bhorst519/bluecar/EIM/pcb/EIM/EIM_BOM.xlsx

Item # | *Designator | *Qty | Manufacturer | *Mfg Part # | Description / Value | *Package/Footprint | Type | Your Instructions / Notes
1 | D15,D29,D28 | 3 | Littelfuse | SD05-01FTG | TVS Diode 5V 450W Unidirectional | D_SOD-323 | SMD
2 | D19,D25,D21,D14,D11,D24,D16,D13,D31,D17,D30,D20,D18,D22,D23 | 15 | Littelfuse | SD15-01FTG | TVS Diode 15V 450W Unidirectional | D_SOD-323 | SMD
3 | J1 | 1 | JAE | MX34028NF2 | Automotive 28P Connector | MX34028NF2 | DNS | DO NOT PLACE
4 | R53,R27,R47,R49,R31,R51,R37,R33,R43,R29,R45,R41,R39,R35 | 14 | YAGEO | RT0805FRE07470RL | RES 470 ohm 1/8W 1% 0805 SMD | R_0805 | SMD | EQUIVALENT PART OKAY
5 | R15,R18 | 2 | YAGEO | RC0805JR-1310KL | RES 10kohm 1/8W 5% 0805 SMD | R_0805 | DNS | DO NOT PLACE
6 | IC3,IC10,IC9,IC7,IC5,IC4,IC6,IC8 | 8 | Vishay | ILD213T | Optocouplers Phototransistor Dual Output | SOIC127P610X350-8N | SMD
7 | U8,U9,U7,U5,U6,U10,U11 | 7 | Infineon | BTS6142D | Smart High Side 1 Ch 39V 100A | TO-252-4 | SMD
8 | J5,J6 | 2 | Samtec | SSW-110-03-T-D | Socket Strip Header .100" Pitch 2X10 | PinHeader_2x10_P2.54mm | DNS | DO NOT PLACE
9 | R38,R25,R62,R24,R42,R46,R71,R50,R70,R34,R74,R30,R8,R26,R66,R17,R75,R91,R59,R58,R63,R67,R92,R55 | 24 | YAGEO | RC0805JR-1310KL | RES 10kohm 1/8W 5% 0805 SMD | R_0805 | SMD | EQUIVALENT PART OKAY
10 | C7,C16,C38,C41,C27,C26,C18,C32,C46,C37,C15,C45,C48,C47,C12,C19,C39,C14,C5,C8,C33,C13,C2,C17,C43,C9,C10,C36,C31,C40,C6,C42,C11,C35,C44,C1,C25,C30,C21 | 39 | KYOCERA AVX | 08055C104J4Z4A | CAP 100nF 50V X7R 0805 SMD | C_0805 | SMD | EQUIVALENT PART OKAY
11 | R4,R23,R61,R73,R64,R89,R68,R56,R72,R65,R87,R90,R57,R2,R69,R88,R16,R22,R60 | 19 | YAGEO | RC0805JR-131KL | RES 1kohm 1/4W 5% 0805 SMD | R_0805 | SMD | EQUIVALENT PART OKAY
12 | Q5,Q2,Q1,Q6,Q4,Q3,Q7 | 7 | omsemi | BSS138 | MOSFET N-CH LOGIC 50V 220mA | SOT-23 | SMD
13 | D2 | 1 | Lumex | SML-LXF0805SIC-TR | Standard LED Red 0805 SMD | LED_0805 | SMD | EQUIVALENT PART OKAY
14 | SW1,SW2 | 2 | C&K | PTS645SM43SMTR92 LFS | Tactile Switches 6 mm SMD | SW_SPST_PTS645 | SMD
15 | D10 | 1 | Vishay | VS-1EFH01-M3/I | Rectifiers Hypfst 1A 100V DO-219AB-2 SMD | D_SMF (DO-219AB-2) | SMD
16 | K1 | 1 | Omron | G8N-1L-AS DC12 | Automotive Mini Relay 12V 30A | G8N1LASDC12 | DNP
17 | S3,S2,S1 | 3 | Infineon | BTS3800SLHTSA1 | Automotive Lowside Relay Driver | BTS3800SLHTSA1 | SMD
18 | FB2 | 1 | TDK | MPZ2012S221AT000 | Ferrite Bead 220ohms 3A 25% 0805 SMD | L_0805 | SMD | EQUIVALENT PART OKAY
19 | D5 | 1 | Lumex | SML-LXT0805YW-TR | Standard LED Yellow 0805 SMD | LED_0805 | SMD | EQUIVALENT PART OKAY
20 | R10,R19,R14,R13 | 4 | YAGEO | AC0805FR-07120RL | RES 120ohm 1/8W 1% 0805 SMD | R_0805 | SMD | EQUIVALENT PART OKAY
21 | R78,R83,R80,R86,R76 | 5 | Panasonic | ERJ-UP6D3601V | RES 3.6kohm 1/8W 0.5% 0805 SMD | R_0805 | SMD | EQUIVALENT PART OKAY
22 | C29,C28 | 2 | Panasonic | EEE-FN1C220R | CAP Electrolytic 22uF 16VDC 20% 90mA AEC-Q200 | CP_Elec_4x5.8 | SMD
23 | R12,R32,R44,R40,R52,R11,R9,R28,R36,R48 | 10 | Vishay | CRCW08050000Z0ECC | RES 0ohm 1/8W 0805 SMD | R_0805 | SMD | EQUIVALENT PART OKAY
24 | C24,C20,C23 | 3 | Samsung | CL31B106KBHNNNE | CAP MLCC 10uF 50V X7R 10% 1206 SMD | C_1206 | SMD
25 | F1 | 1 | Littelfuse | 1206L035/16YR | Polyfuse PTC 16V 0.350A 1206 SMD | Fuse_1206 | SMD
26 | F2 | 1 | Littelfuse | 2920L600/16MR | Polyfuse PTC 16V 6.0A 2920 SMD | Fuse_2920 | SMD
27 | R20,R21 | 2 | Vishay | CRCW080510R0FKEA | RES thick film 10ohm 1/8W 1% 0805 SMD | R_0805 | SMD | EQUIVALENT PART OKAY
28 | F5 | 1 | Littelfuse | 1206L010/60WR | Polyfuse PTC 60V 0.100A 1206 SMD | Fuse_1206 | SMD
29 | R84,R79,R81,R77 | 4 | Panasonic | ERJ-P06D1001V | RES 1kohm 1/8W 0.5% 0805 SMD | R_0805 | SMD | EQUIVALENT PART OKAY
30 | U1 | 1 | STMicroelectronics | STM32F429ZIT6 | ARM MCU CortexM4 2Mb Flash 180MHz | LQFP-144_20x20mm_P0.5mm | SMD
31 | J7 | 1 | Samtec | FTSH-107-01-F-DV-K | 14-pin Header Strip, .050" pitch | FTSH-107-XX-YYY-DV-K | SMD
32 | R82 | 1 | Bourns | CR2512-JW-221ELF | RES thick film 220ohm 1W 5% 2512 SMD | R_2512 | SMD | EQUIVALENT PART OKAY
33 | R6,R54,R5,R85 | 4 | Panasonic | ERA-6AED221V | RES 220ohm 1/8W 0.5% 0805 SMD | R_0805 | SMD | EQUIVALENT PART OKAY
34 | X1 | 1 | ABRACON | ASE-8.000MHz-E-T | Standard Clock Oscillator 8.000MHZ CMOS SMD | Oscillator_ASE-4Pin_3.2x2.5mm | SMD
35 | D4 | 1 | Lumex | SML-LX0805DRC-TR | Standard LED Deep Red 0805 SMD | LED_0805 | SMD | EQUIVALENT PART OKAY
36 | D6 | 1 | Diotec | SK22 | Schottky Diode, 20V, 2A, SMB SMD | D_SMB | SMD
37 | FB1 | 1 | Wurth Elektronik | 742792040 | Ferrite Bead 600ohms 2A 25% 0805 SMD | L_0805 | SMD | EQUIVALENT PART OKAY
38 | IC2 | 1 | Renesas | ISL3172EIBZ | RS-485 Interface IC SOIC-8 SMD | SOIC-8_3.9x4.9mm_P1.27mm | SMD
39 | U4,U3 | 2 | Texas Instruments | SN65HVD233 | CAN Interface IC Standby Mode SOIC-8 SMD | SOIC-8_3.9x4.9mm_P1.27mm | SMD
40 | D26,D27 | 2 | Littelfuse | SD12-01FTG | TVS Diode 12V 450W Unidirectional | D_SOD-323 | SMD
41 | D12,D8,D9 | 3 | Littelfuse | SM24CANB-02HTG | TVS Diode 500W 24V 2 CH SOT23 SMD | SOT-23-3 | SMD
42 | R3,R1 | 2 | YAGEO | RT0603FRE0715KL | RES 15kohm 1/8W 1% 0805 SMD | R_0805 | SMD | EQUIVALENT PART OKAY
43 | C4,C3 | 2 | YAGEO | CC1206KKX7R7BB225 | CAP MLCC 2.2uF 16V X7R 10% 1206 SMD | C_1206 | SMD
44 | J8 | 1 | Samtec | TSW-106-07-T-S | Male Header Strip 0.1" Pitch 1X6 | PinHeader_1x06_P2.54mm_Vertical | DNS | DO NOT PLACE
45 | X2 | 1 | ECS | ECS-327MVATX-3-CN-TR3 | Standard Clock Oscillators 32.768KHZ SMD | Oscillator_ASE-4Pin_3.2x2.5mm | SMD
46 | L1 | 1 | Bourns | SRN8040-3R6Y | Power Inductors 3.6uH 30% 8040 SMD | L_Bourns-SRN8040_8x8.15mm | SMD
47 | IC1 | 1 | Texas Instruments | TLIN1027DRQ1 | Automotive LIN Transceiver SOIC-8 SMD | SOIC-8_3.9x4.9mm_P1.27mm | SMD
48 | J4 | 1 | Molex | 34830-2001 | Automotive Connector MX150 RA 2X10 BLK KEY A | 348302001 | DNS | DO NOT PLACE
49 | C22 | 1 | Wurth Elektronik | 885012207078 | CAP MLCC 1.0uF 25V X7R 10% 0805 SMD | C_0805 | SMD
50 | R7 | 1 | YAGEO | AC0805FR-7W1K5L | RES 1.5kohm 1/4W 1% 0805 SMD | R_0805 | SMD | EQUIVALENT PART OKAY
51 | F3,F4 | 2 | Littelfuse | 2920L260/33DR | Polyfuse PTC 33V 2.6A 2920 SMD | Fuse_2920 | SMD
52 | J3 | 1 | Molex | 34830-0801 | Automotive Connector MX150 RA 2X4 BLK KEY A | 348300801 | DNS | DO NOT PLACE
53 | C34 | 1 | KEMET | C0805C221J5GAC | CAP 220pF 50V C0G 0805 5% SMD | C_0805 | SMD | EQUIVALENT PART OKAY
54 | D7 | 1 | Bourns | SMBJ15A | TVS Diode 15volts 5uA 24 Amps Unidirectional | D_SMB | SMD
55 | D3 | 1 | Lumex | SML-LXT0805GW-TR | Standard LED Green 0805 SMD | LED_0805 | SMD | EQUIVALENT PART OKAY
56 | U2 | 1 | Diodes Incorporated | AP63203WU-7 | Switching Voltage Regulators DCDC 3.3V Output | TSOT-23-6 | SMD
57 | J2 | 1 | Molex | 36783-1201 | Automotive Connectors MX120G RA 2X6 | 367831201 | DNS | DO NOT PLACE
58 | D1 | 1 | Cree LED | CLV1L-FKB-CJ1N1E1BB7B3B3 | Multi-Color LEDs RGB SMD | LED_Cree-PLCC4_3.2x2.8mm_CCW | SMD
