bhorst519/bluecar/(threads)

Thread 29 (2025-04-30):

Properly relay APS and switch info from VCU -> EIM

aguynamedsterl, 2025-04-30:
My hacky approach today ([PR](https://github.com/bhorst519/bluecar/pull/28)) is using the VCU_PcbaVitals message, which was intended to be debug-only and TXed at 10Hz. To accommodate use in powertrain control,  I increased the TX rate to 100Hz and have EIM consuming the message. We should create a proper, dedicated interface for these control signals
