bhorst519/bluecar/EIM/pcb/EIM/EIM.pdf

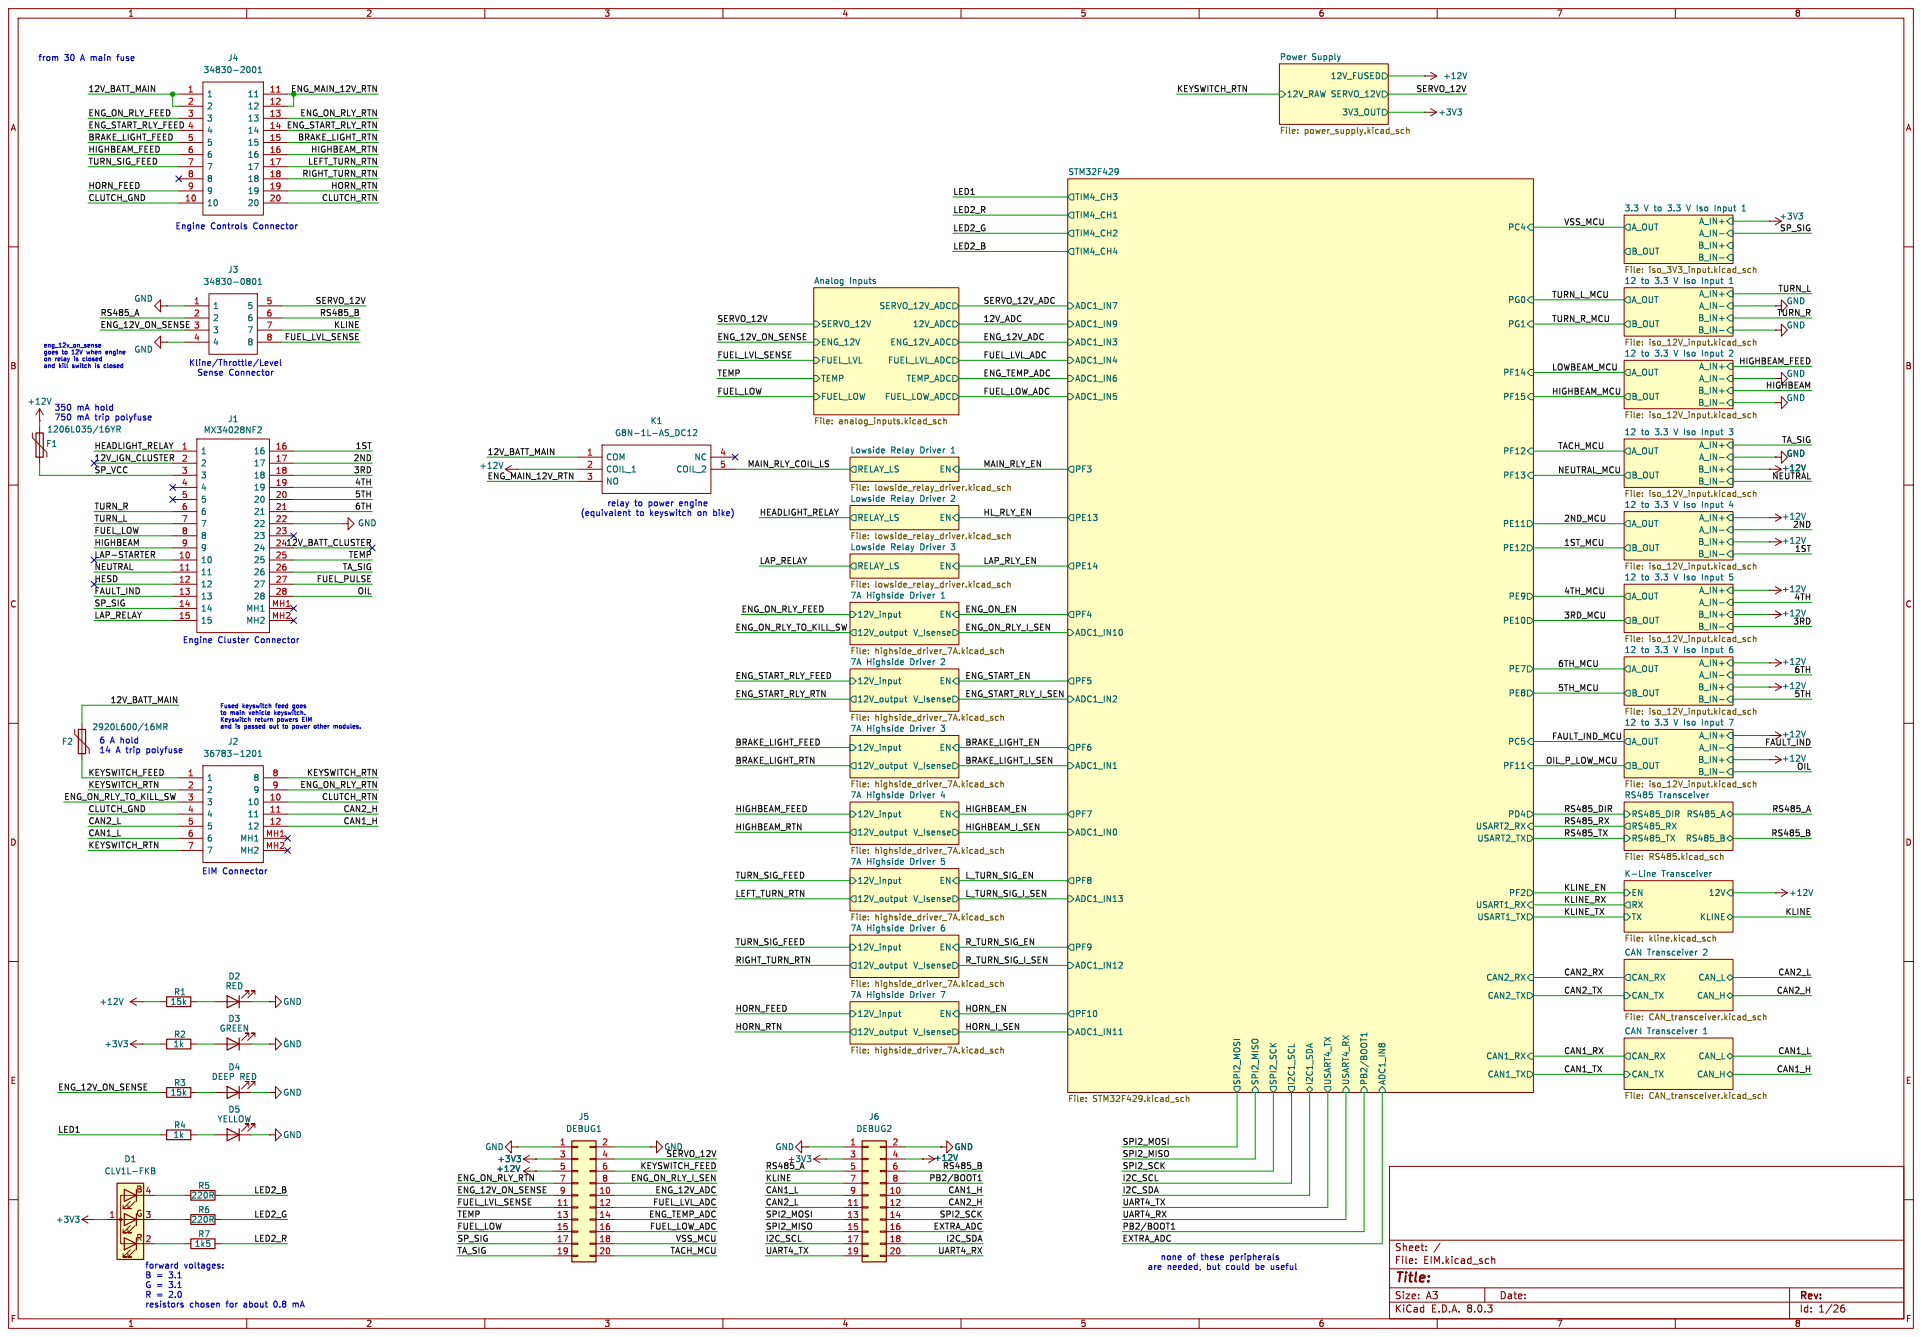
[picture p1: page 1]

3.3 V to 3.3 V Iso Input 1 File: iso_3V3_input.kicad_sch A_IN+ A_IN- B_IN+ B_IN- B_OUT A_OUT
A_IN+ A_IN- B_IN+ B_IN- B_OUT A_OUT

12 to 3.3 V Iso Input 3 File: iso_12V_input.kicad_sch A_IN+ A_IN- B_IN+ B_IN- B_OUT A_OUT

eng_12v_on_sense
goes to 12V when engine
on relay is closed
and kill switch is closed 350 mA hold

12 to 3.3 V Iso Input 2 File: iso_12V_input.kicad_sch

relay to power engine

12 to 3.3 V Iso Input 4 File: iso_12V_input.kicad_sch A_IN+ A_IN- B_IN+ B_IN- B_OUT A_OUT

12 to 3.3 V Iso Input 5 File: iso_12V_input.kicad_sch

and is passed out to power other modules. Engine Cluster Connector EIM Connector

12 to 3.3 V Iso Input 7 File: iso_12V_input.kicad_sch

UART4_RX
PB2/BOOT1
EXTRA_ADC
none of these peripherals are needed, but could be useful

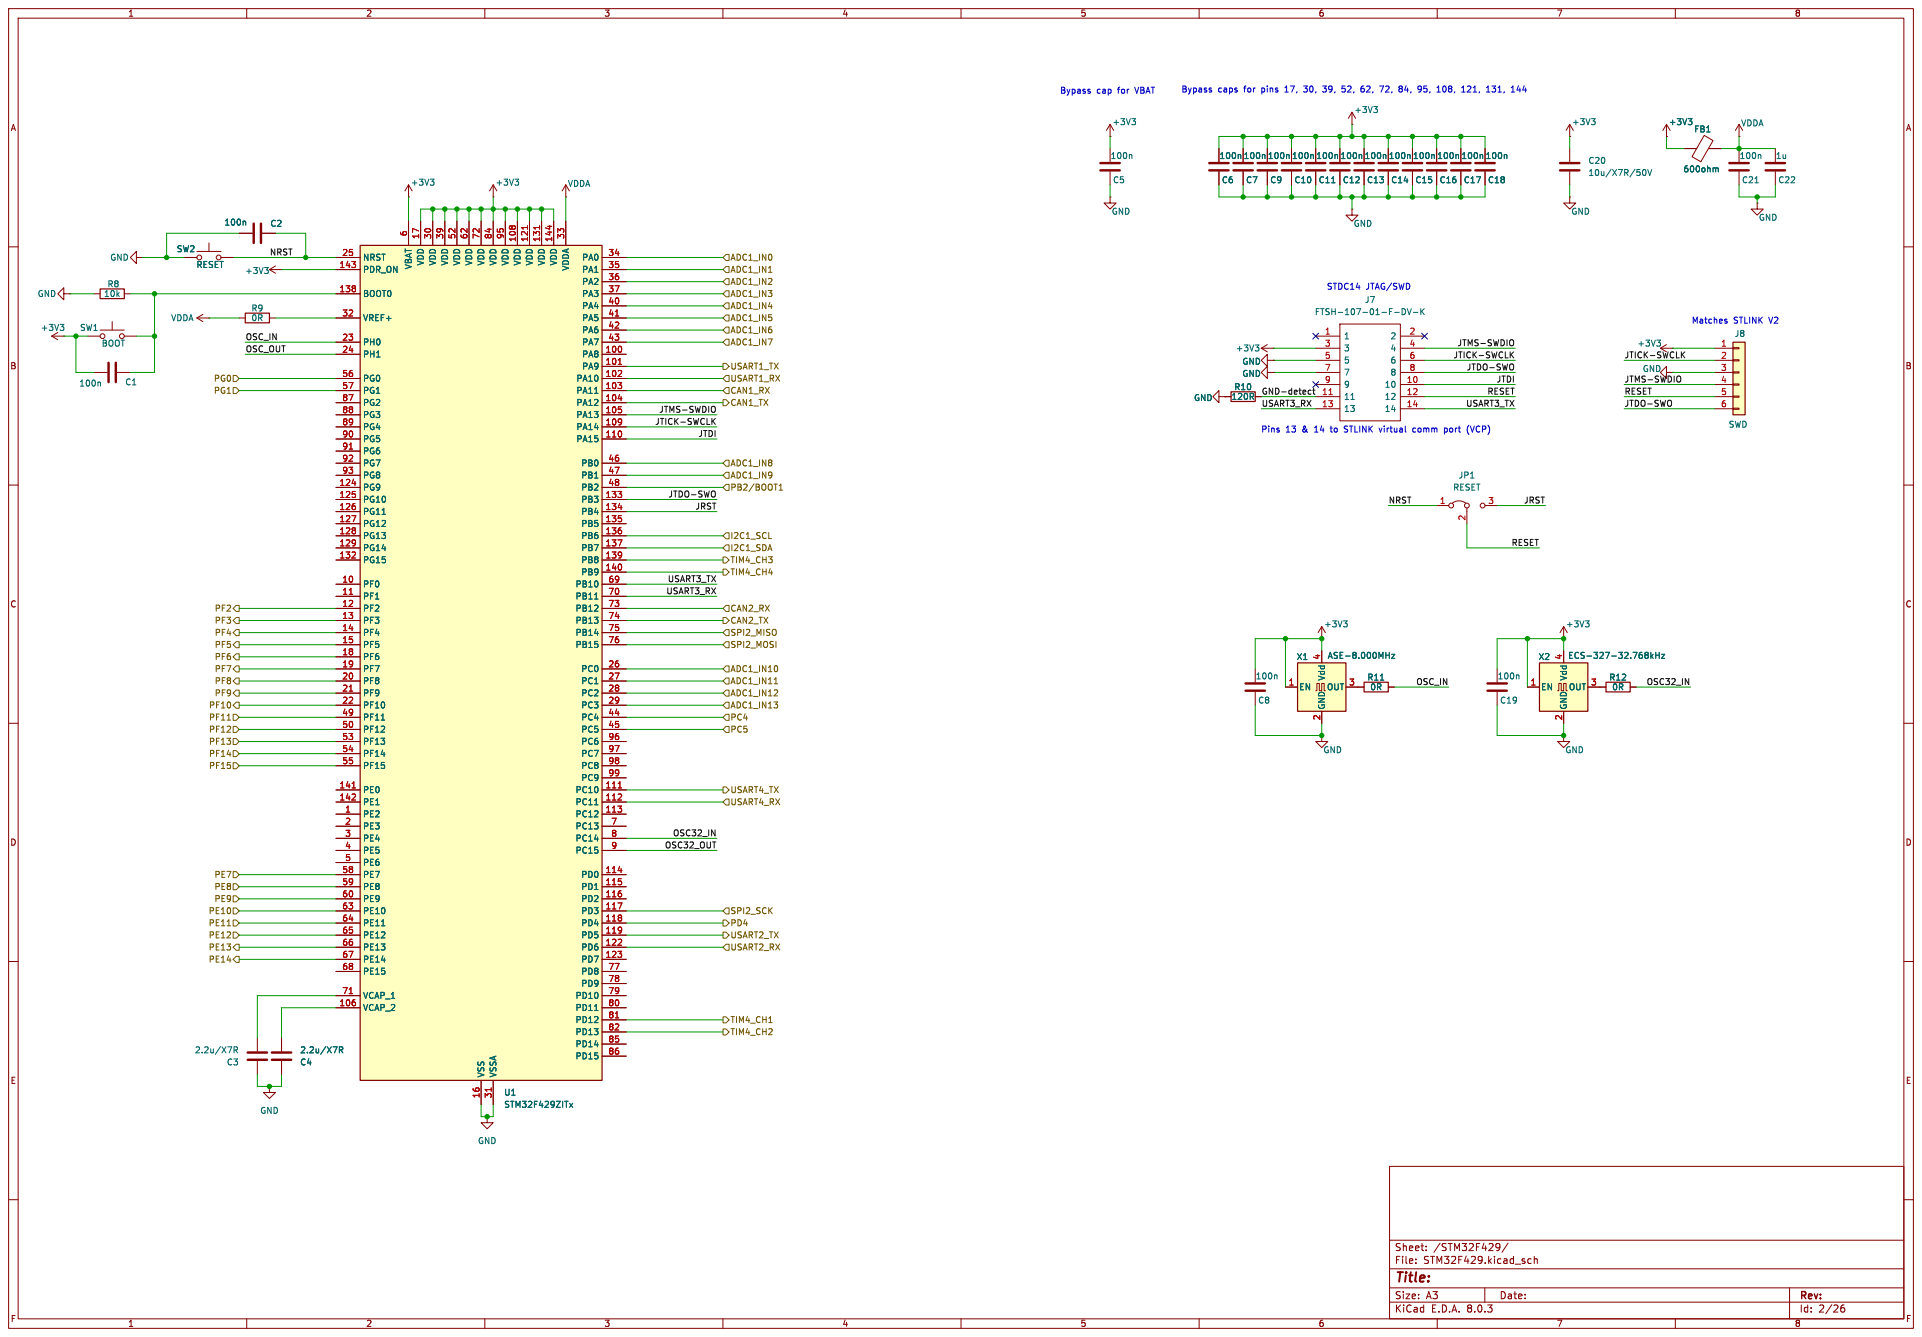
[picture p2: page 2]

J7 FTSH-107-01-F-DV-K GND GND

JTDI JRST RESET RESET NRST

Id: 2/26 Title: File: STM32F429.kicad_sch Sheet: /STM32F429/

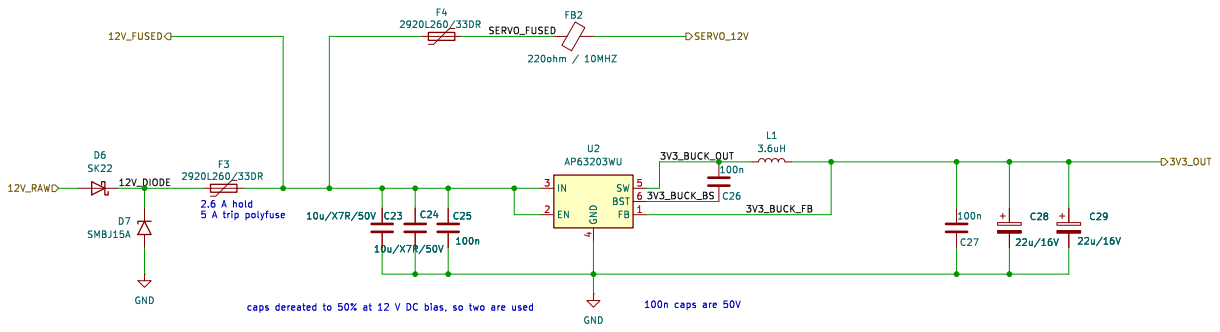
[picture p3: page 3]

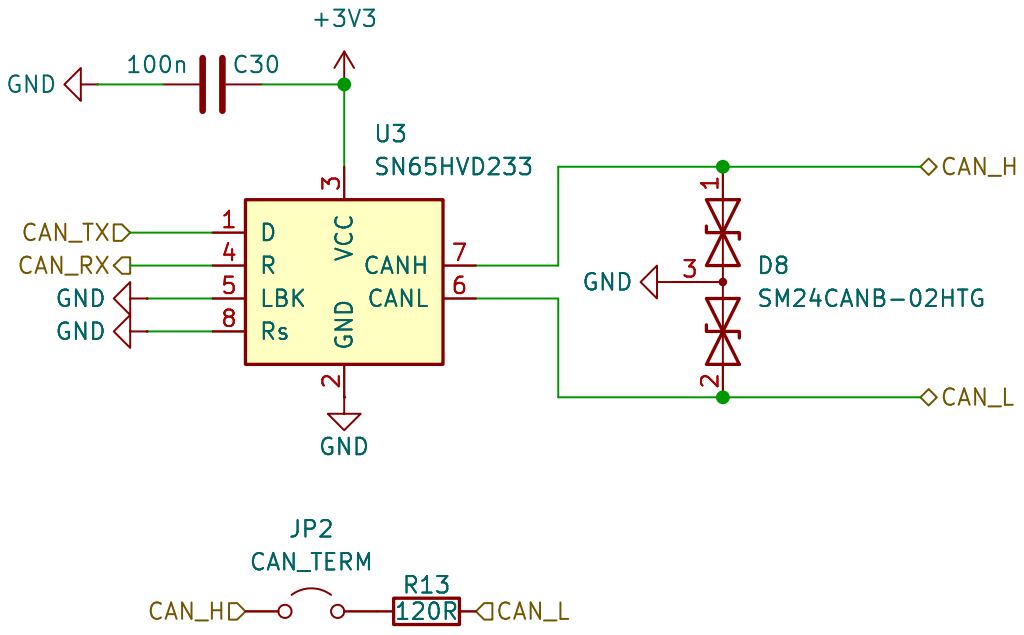
[picture p4: page 4]

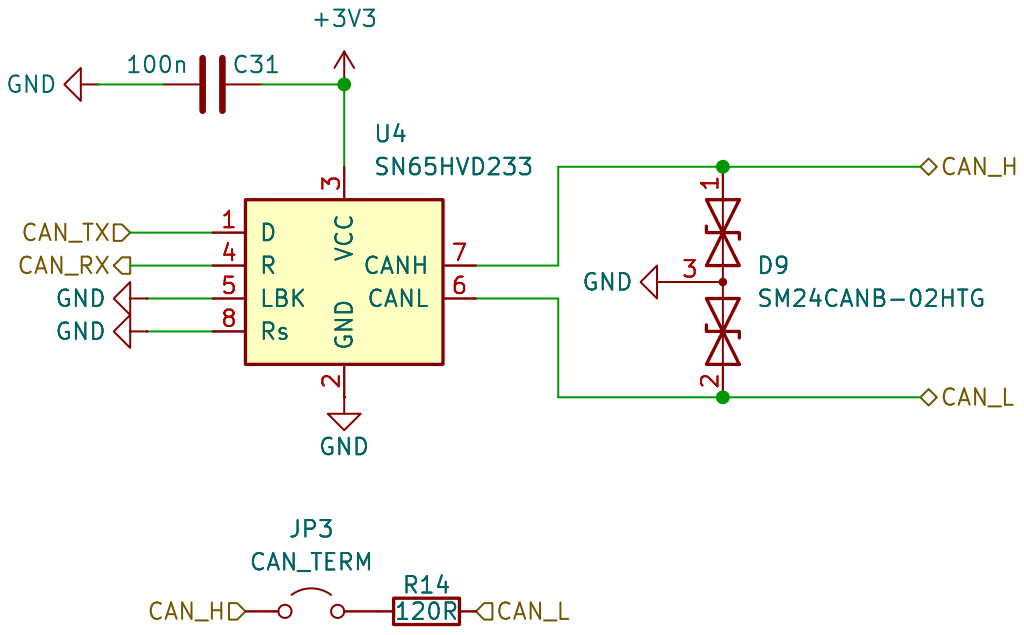
[picture p5: page 5]

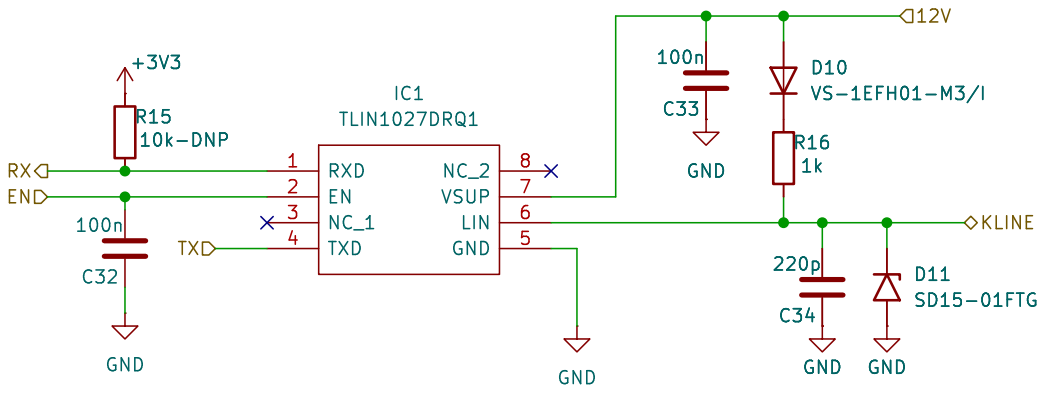
[picture p6: page 6]

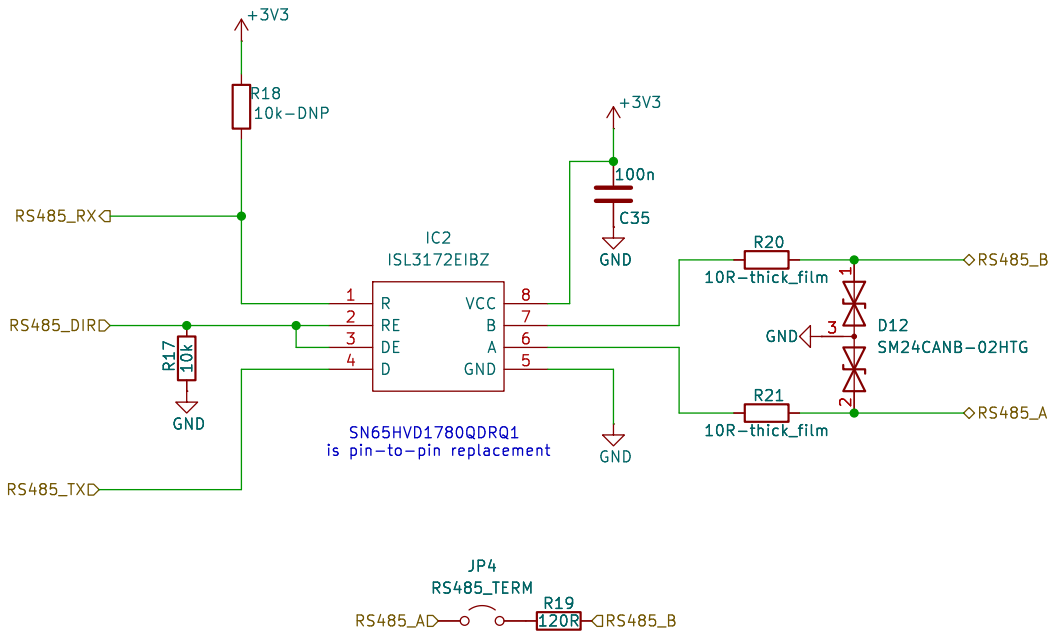
[picture p7: page 7]

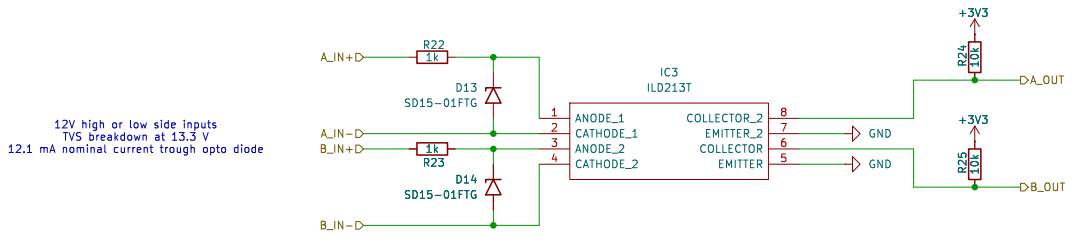
[picture p8: page 8]

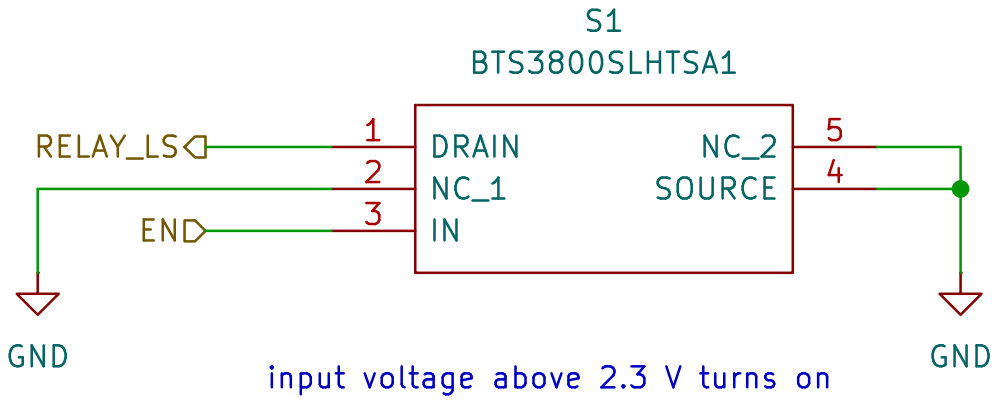
[picture p9: page 9]

input voltage above 2.3 V turns on

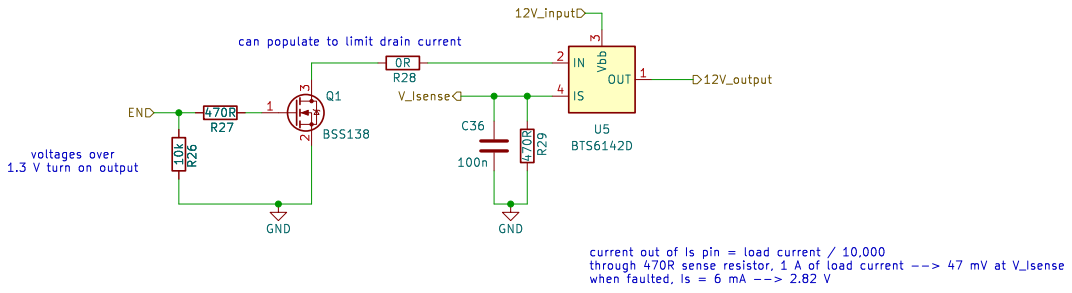
[picture p10: page 10]

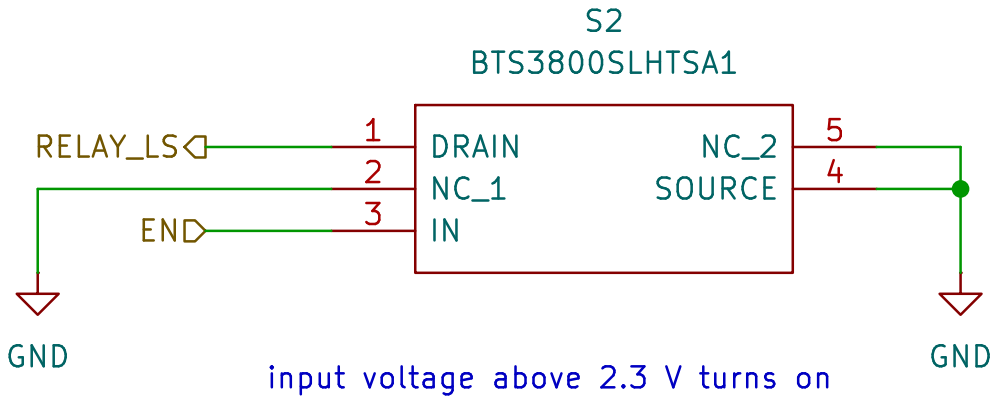
[picture p11: page 11]

input voltage above 2.3 V turns on

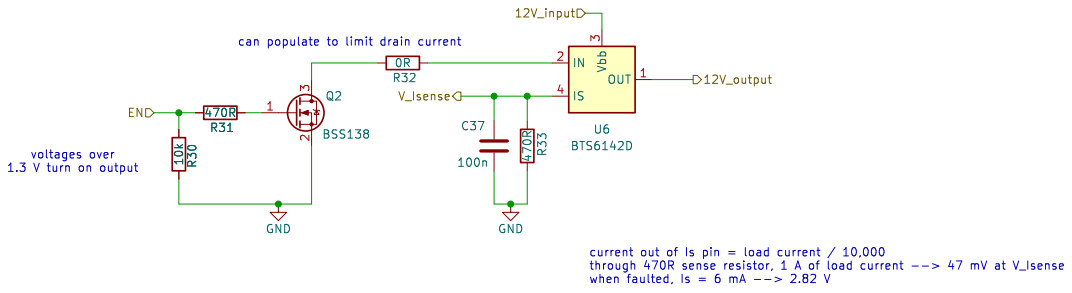
[picture p12: page 12]

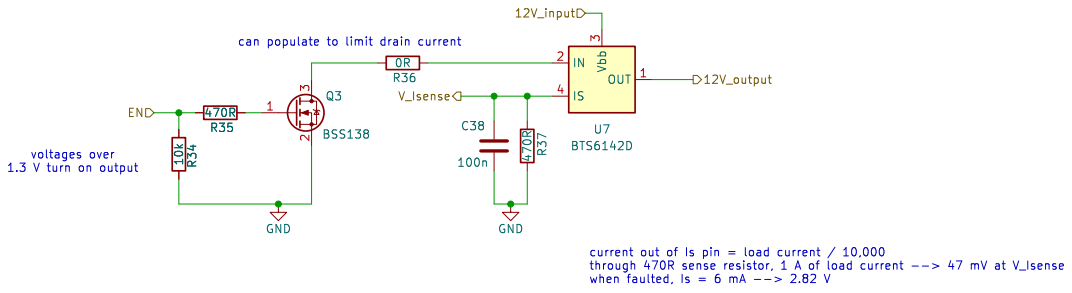
[picture p13: page 13]

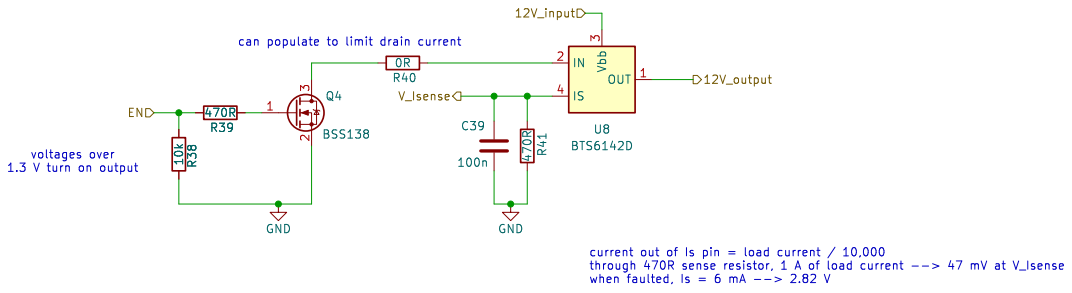
[picture p14: page 14]

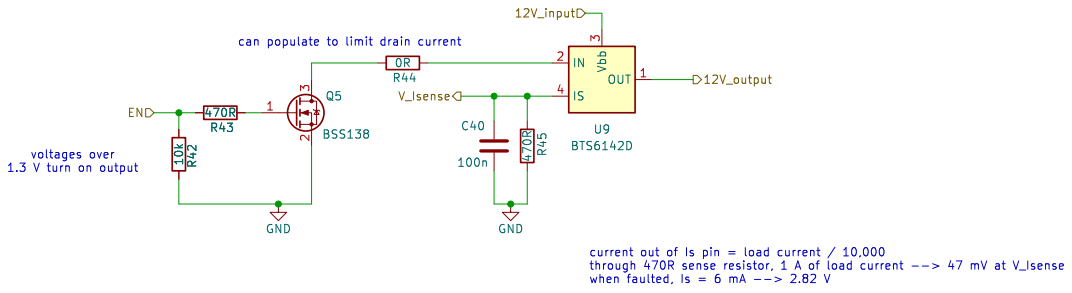
[picture p15: page 15]

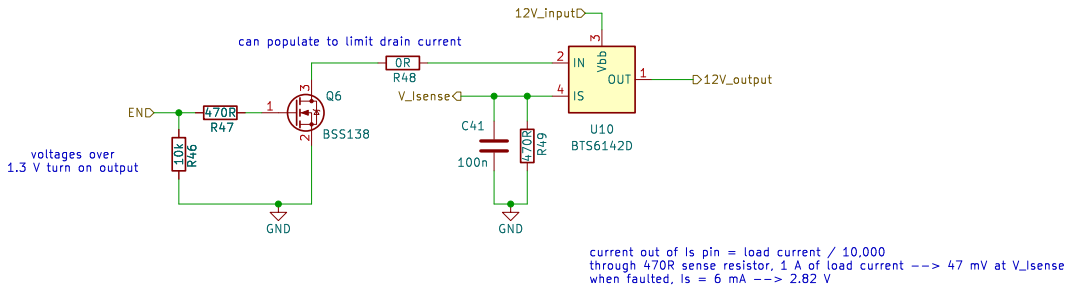
[picture p16: page 16]

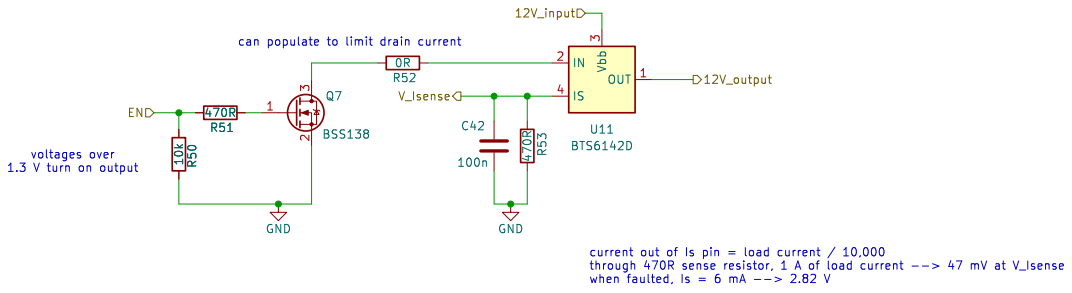
[picture p17: page 17]

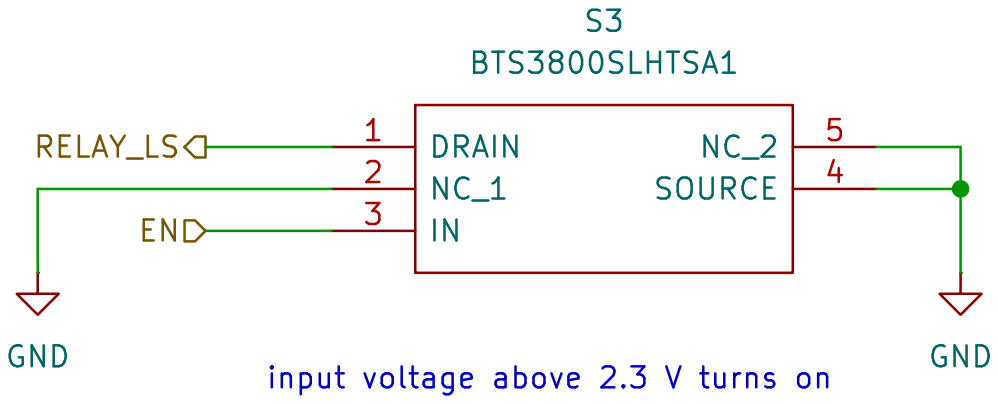
[picture p18: page 18]

input voltage above 2.3 V turns on

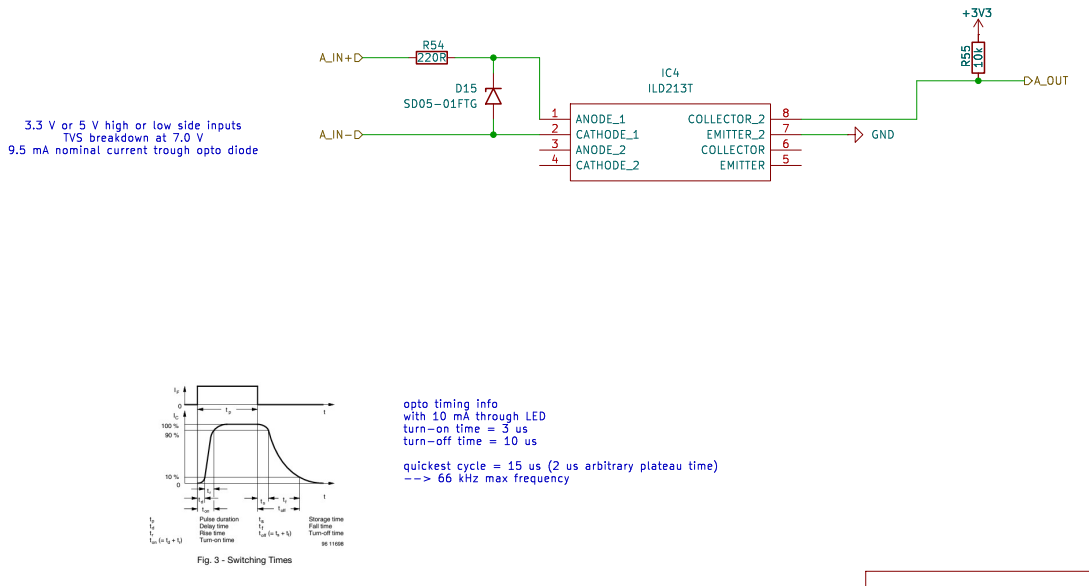
[picture p19: page 19]

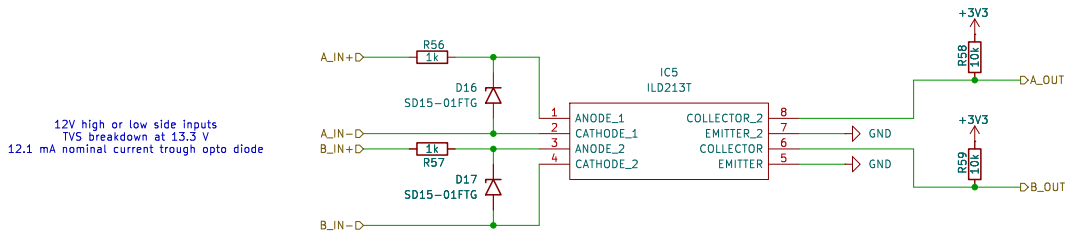
[picture p20: page 20]

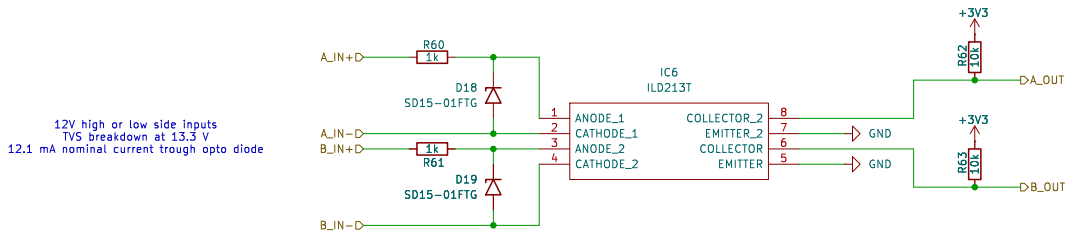
[picture p21: page 21]

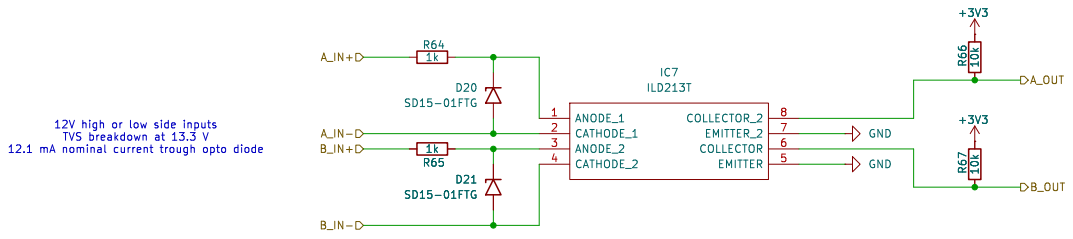
[picture p22: page 22]

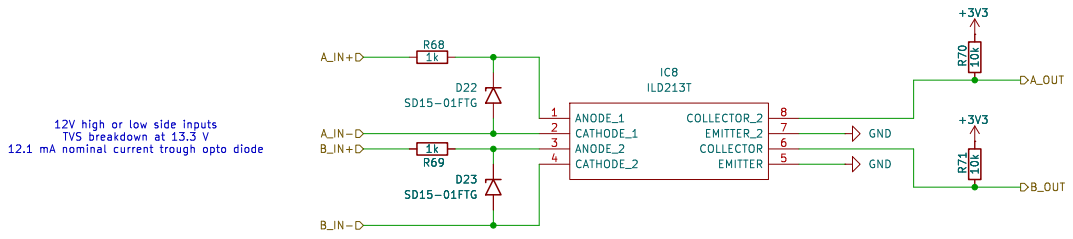
[picture p23: page 23]

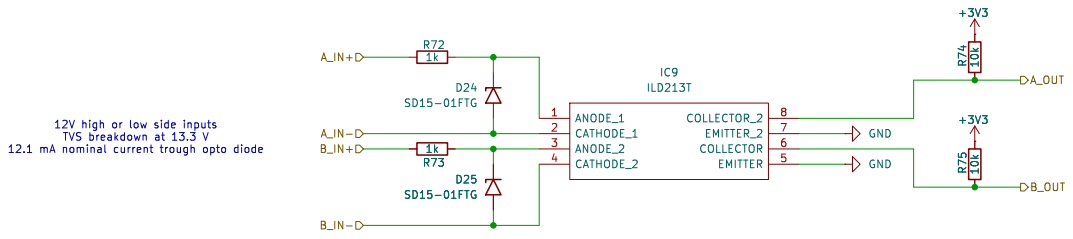
[picture p24: page 24]

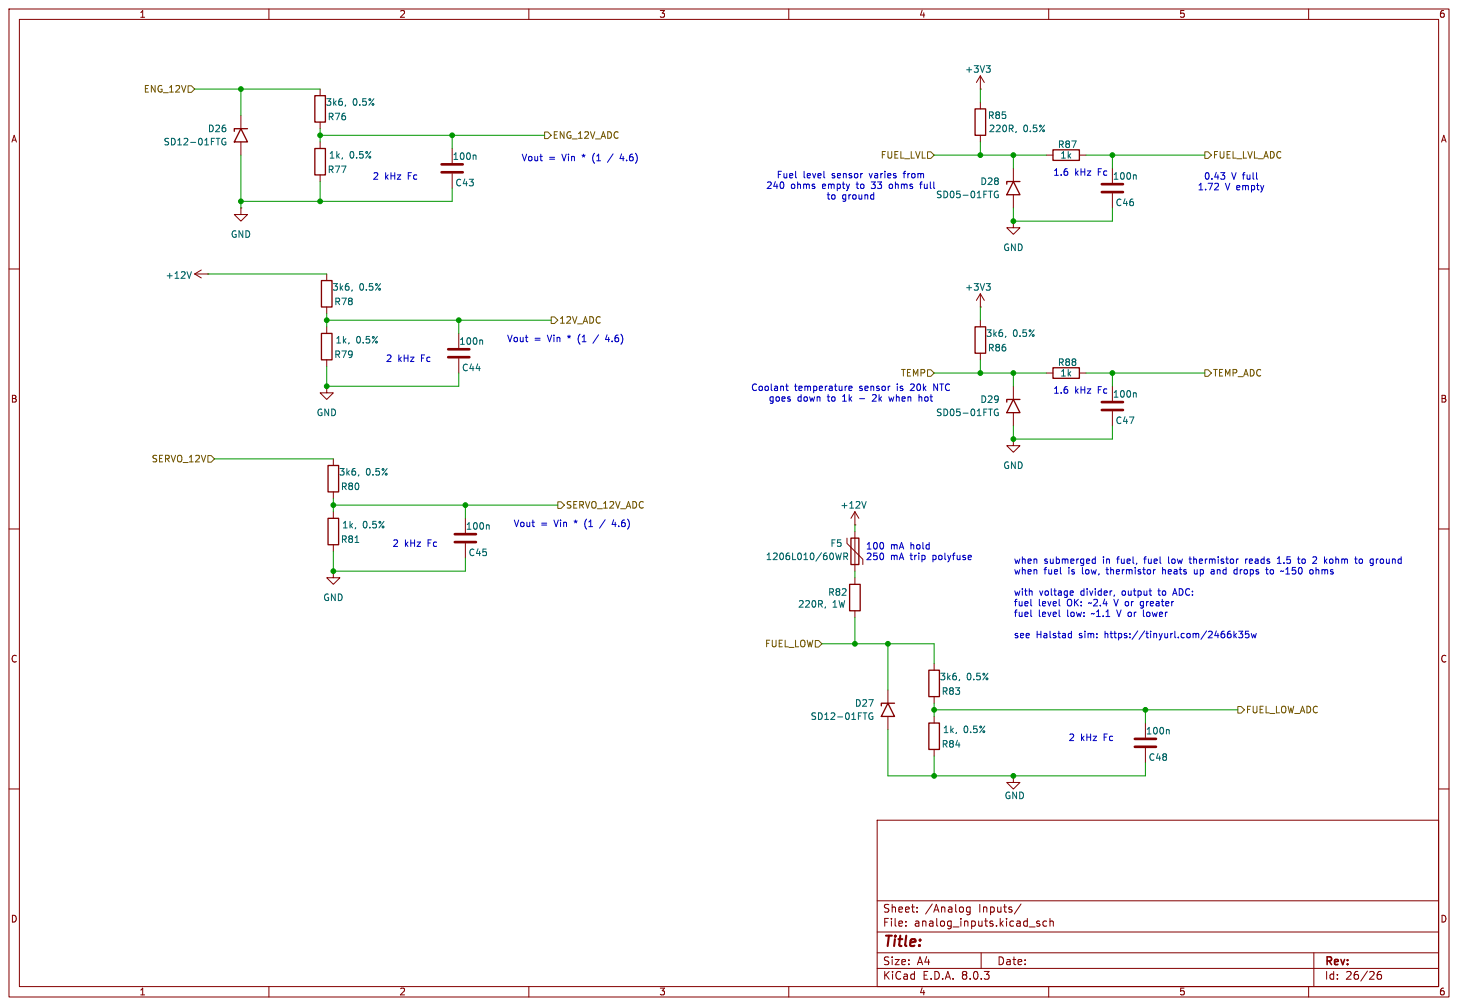
[picture p25: page 25]

240 ohms empty to 33 ohms full to ground

fuel level OK: ~2.4 V or greater
fuel level low: ~1.1 V or lower see Halstad sim: https://tinyurl.com/2466k35w

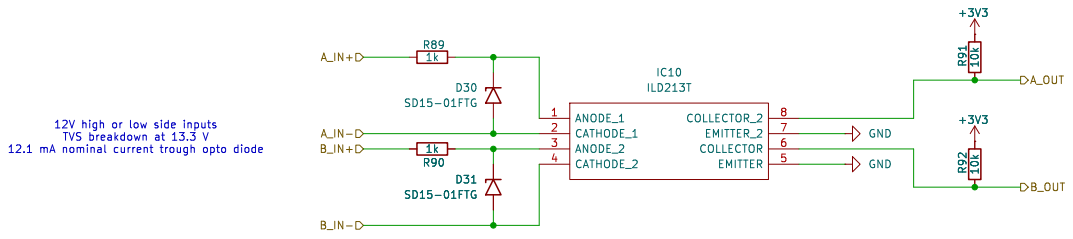
[picture p26: page 26]
