bhorst519/bluecar/VCU/temp_pcb/temp_vcu/temp_vcu.pdf

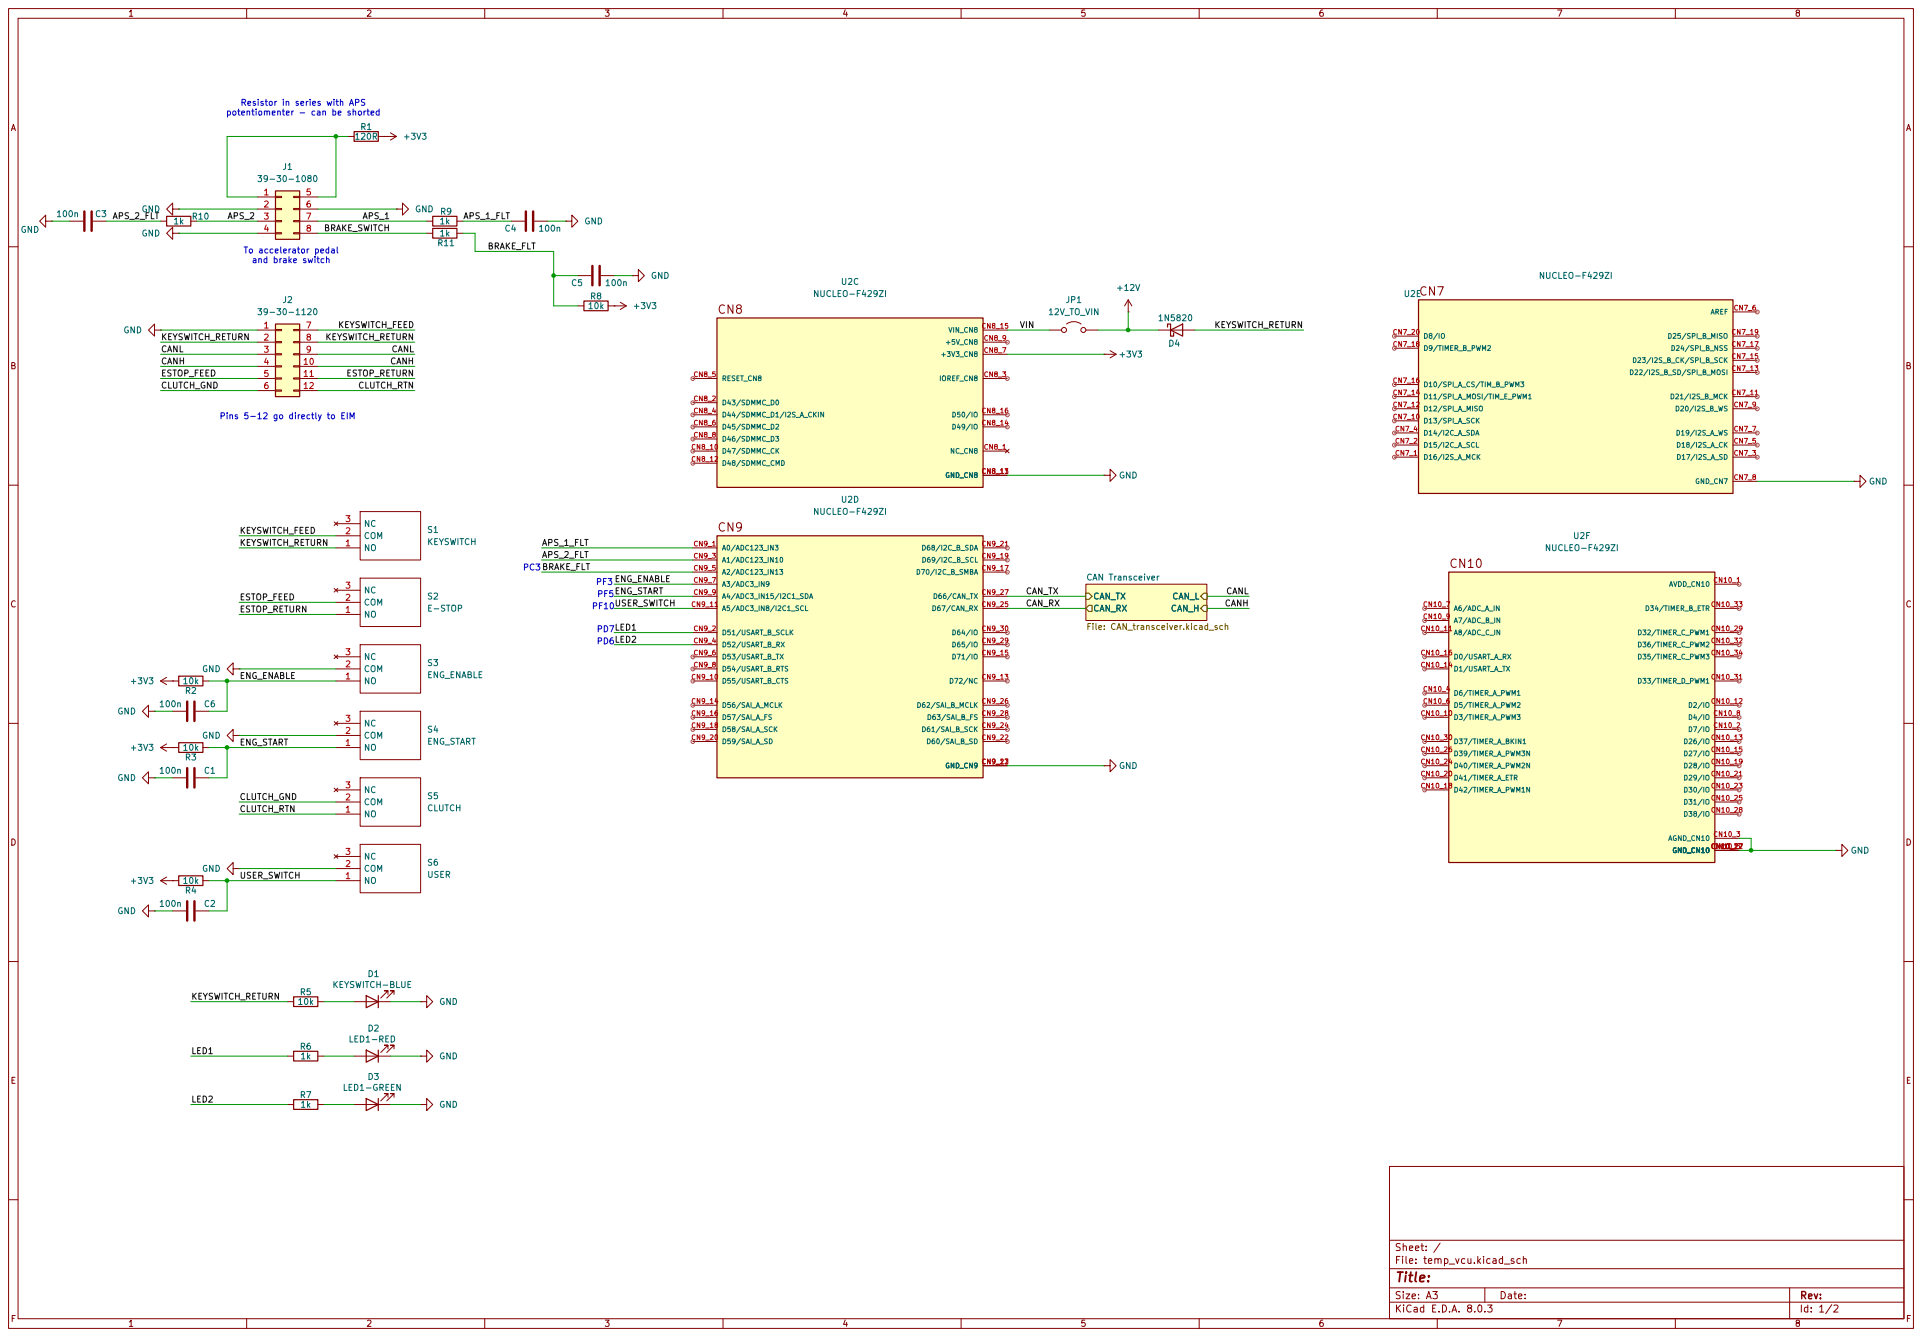
[picture p27: page 1]

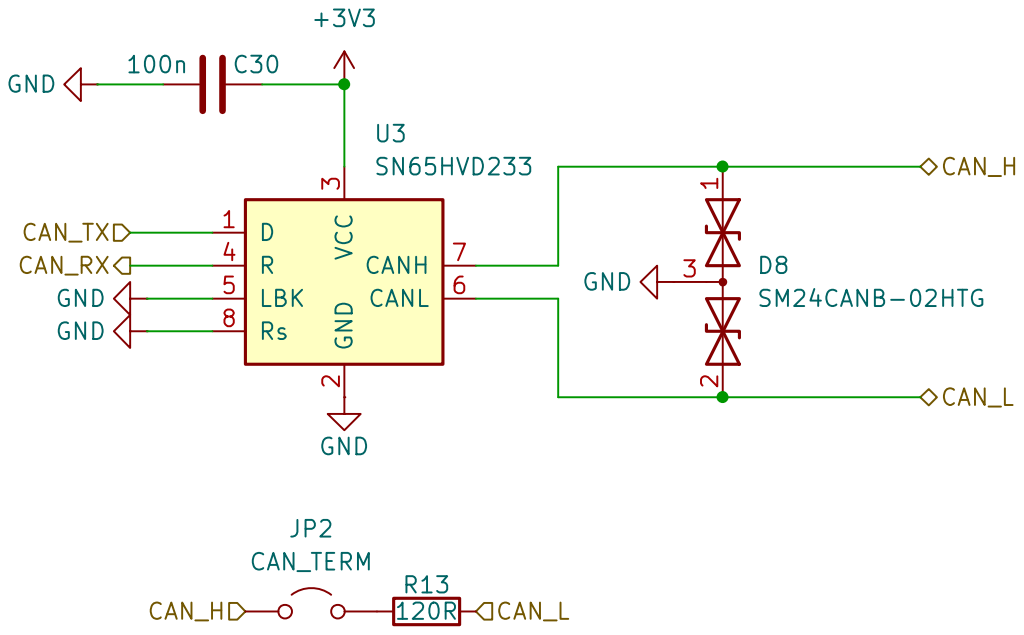
[picture p28: page 2]
