bhorst519/bluecar/VCU/temp_pcb/temp_vcu/temp_vcu.kicad_pcb

## KiCad design VCU/temp_pcb/temp_vcu/temp_vcu.kicad_pcb (2025-04-25)

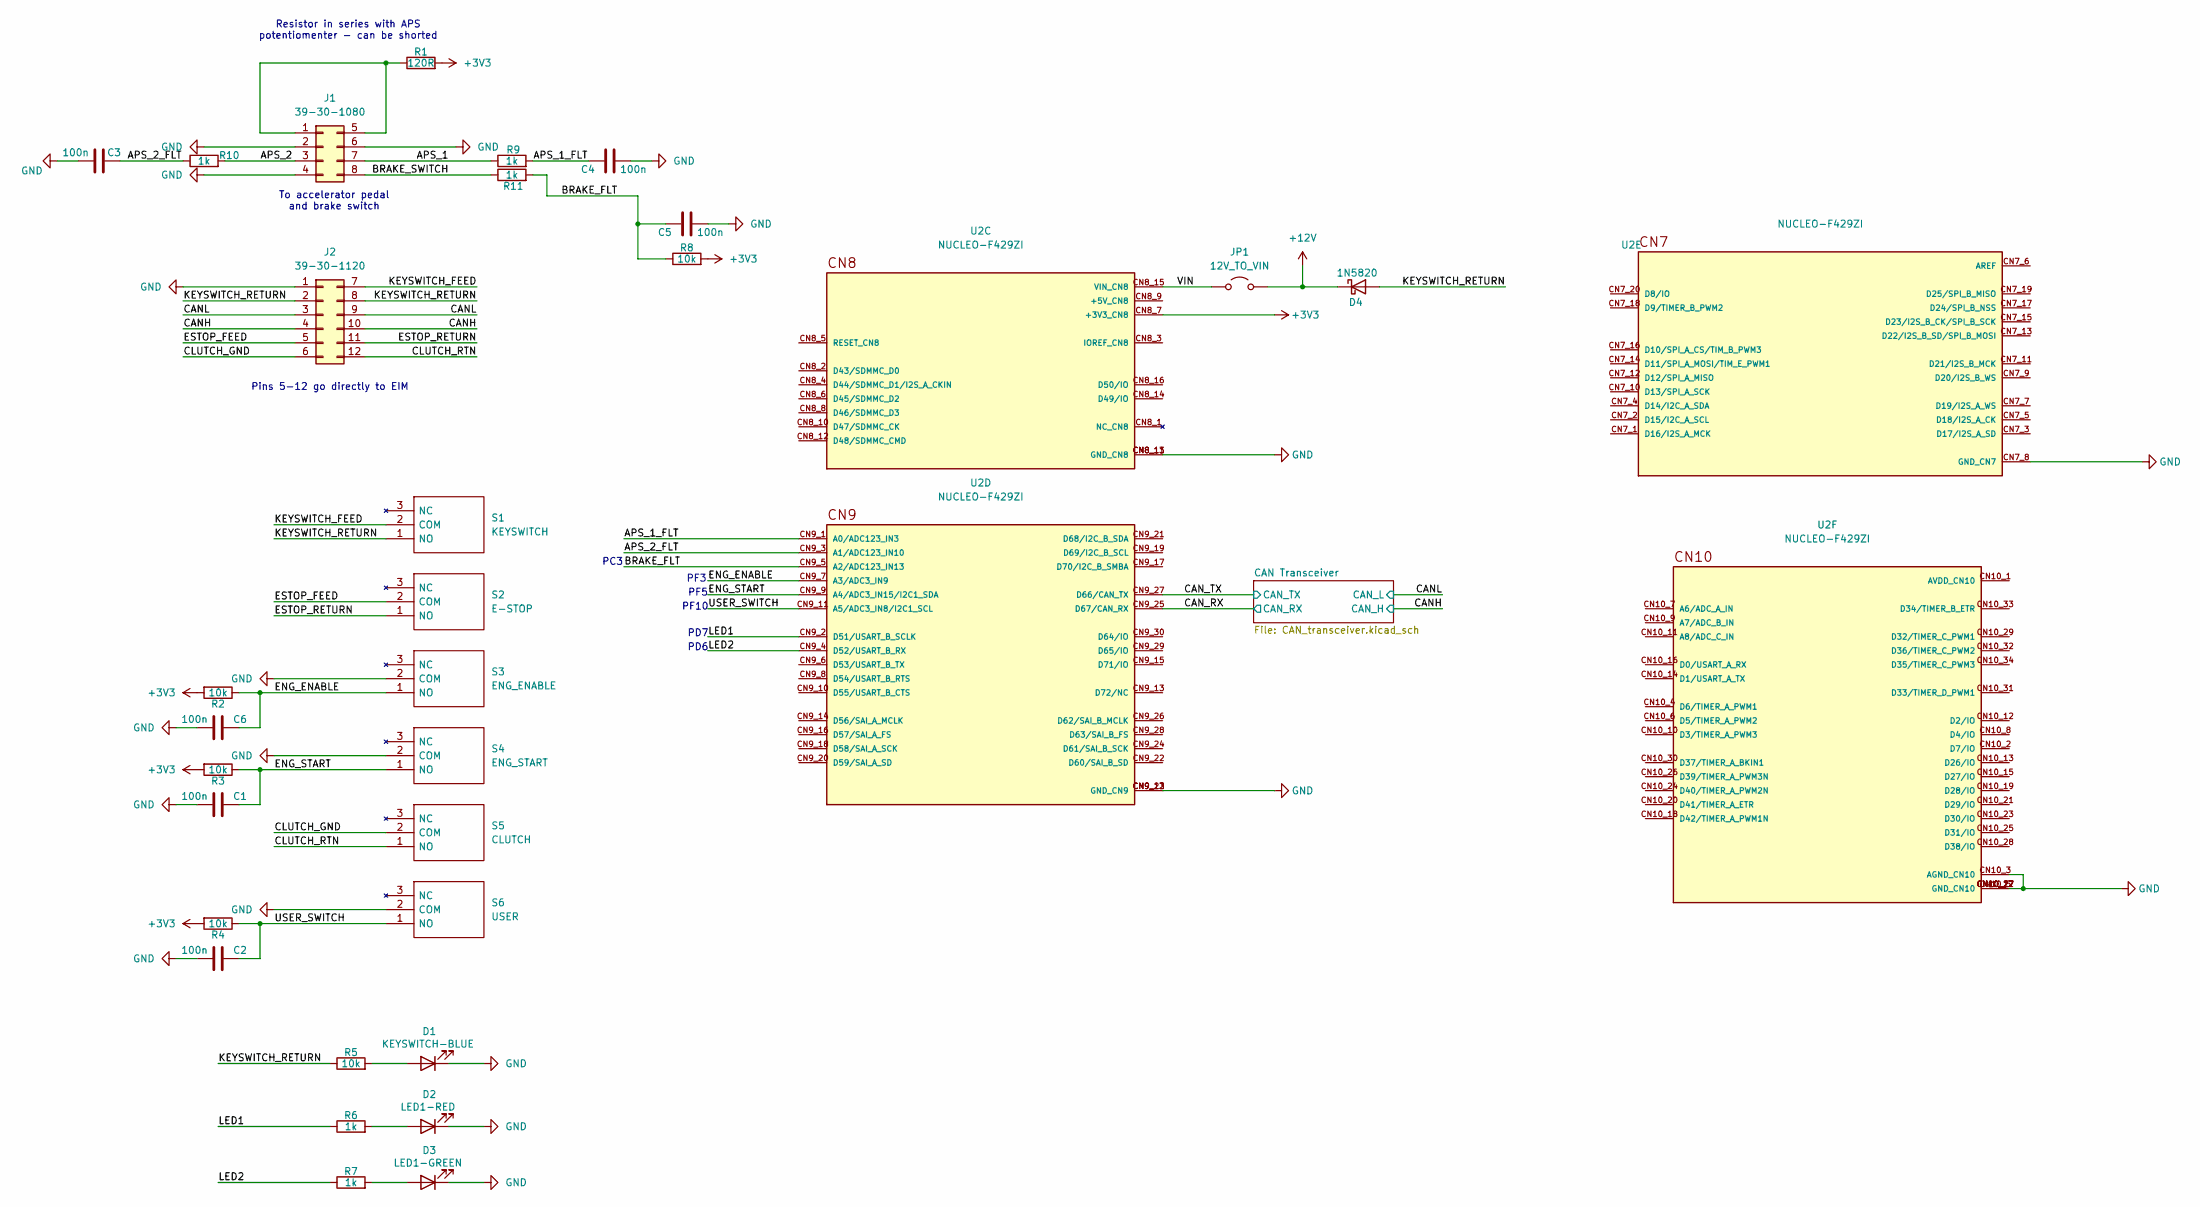
[picture p29: schematic temp_vcu.kicad_sch]

Parts:
C1, C2, C3, C4, C5, C6: 100n; C_0805_2012Metric_Pad1.18x1.45mm_HandSolder
D1: KEYSWITCH-BLUE; LED_D4.0mm
D2: LED1-RED; LED_D4.0mm
D3: LED1-GREEN; LED_D4.0mm
D4: 1N5820; D_DO-201AD_P15.24mm_Horizontal
J1: 39-30-1080; Molex_Mini-Fit_Jr_5569-08A2_2x04_P4.20mm_Horizontal
J2: 39-30-1120; Molex_Mini-Fit_Jr_5569-12A2_2x06_P4.20mm_Horizontal
JP1: 12V_TO_VIN; PinHeader_1x02_P2.54mm_Vertical
R1: 120R; R_Axial_DIN0207_L6.3mm_D2.5mm_P10.16mm_Horizontal
R2, R3, R4, R5, R8: 10k; R_Axial_DIN0207_L6.3mm_D2.5mm_P10.16mm_Horizontal
R6, R7, R9, R10, R11: 1k; R_Axial_DIN0207_L6.3mm_D2.5mm_P10.16mm_Horizontal
S1: KEYSWITCH; 2MS1T2B4M2QES; Mouser Part Number 118-2MS1T2B4M2QES
S2: E-STOP; 2MS1T2B4M2QES; Mouser Part Number 118-2MS1T2B4M2QES
S3: ENG_ENABLE; 2MS1T2B4M2QES; Mouser Part Number 118-2MS1T2B4M2QES
S4: ENG_START; 2MS1T2B4M2QES; Mouser Part Number 118-2MS1T2B4M2QES
S5: CLUTCH; 2MS1T2B4M2QES; Mouser Part Number 118-2MS1T2B4M2QES
S6: USER; 2MS1T2B4M2QES; Mouser Part Number 118-2MS1T2B4M2QES
U2: NUCLEO-F429ZI; MODULE_NUCLEO-F429ZI; PARTREV 8

Connections:
+3V3: R1.2, R2.2, R3.2, R4.2, R8.2, U2.CN8_7 (+3V3_CN8); also elsewhere on the board
+12V: D4.1 (K), JP1.2 (B)
/APS_1: J1.7, R9.1
/APS_1_FLT: C4.2, R9.2, U2.CN9_1 (A0/ADC123_IN3)
/APS_2: J1.3, R10.2
/APS_2_FLT: C3.2, R10.1, U2.CN9_3 (A1/ADC123_IN10)
/BRAKE_FLT: C5.2, R8.1, R11.2, U2.CN9_5 (A2/ADC123_IN13)
/BRAKE_SWITCH: J1.8, R11.1
/CANH: J2.4, J2.10; also elsewhere on the board
/CANL: J2.3, J2.9; also elsewhere on the board
/CAN_RX: U2.CN9_25 (D67/CAN_RX); also elsewhere on the board
/CAN_TX: U2.CN9_27 (D66/CAN_TX); also elsewhere on the board
/CLUTCH_GND: J2.6, S5.2 (COM)
/CLUTCH_RTN: J2.12, S5.1 (NO)
/ENG_ENABLE: C6.2, R2.1, S3.1 (NO), U2.CN9_7 (A3/ADC3_IN9)
/ENG_START: C1.2, R3.1, S4.1 (NO), U2.CN9_9 (A4/ADC3_IN15/I2C1_SDA)
/ESTOP_FEED: J2.5, S2.2 (COM)
/ESTOP_RETURN: J2.11, S2.1 (NO)
/KEYSWITCH_FEED: J2.7, S1.2 (COM)
/KEYSWITCH_RETURN: D4.2 (A), J2.2, J2.8, R5.1, S1.1 (NO)
/LED1: R6.1, U2.CN9_2 (D51/USART_B_SCLK)
/LED2: R7.1, U2.CN9_4 (D52/USART_B_RX)
/USER_SWITCH: C2.2, R4.1, S6.1 (NO), U2.CN9_11 (A5/ADC3_IN8/I2C1_SCL)
/VIN: JP1.1 (A), U2.CN8_15 (VIN_CN8)
GND: C1.1, C2.1, C3.1, C4.1, C5.1, C6.1, D1.1 (K), D2.1 (K), D3.1 (K), J1.2, J1.4, J1.6, J2.1, S3.2 (COM), S4.2 (COM), S6.2 (COM), U2.CN7_8 (GND_CN7), U2.CN8_11 (GND_CN8), U2.CN8_13 (GND_CN8), U2.CN9_12 (GND_CN9), U2.CN9_23 (GND_CN9), U2.CN10_3 (AGND_CN10), U2.CN10_5 (GND_CN10), U2.CN10_17 (GND_CN10), U2.CN10_22 (GND_CN10), U2.CN10_27 (GND_CN10); also elsewhere on the board
unnamed: D1.2 (A), R5.2
unnamed: D2.2 (A), R6.2
unnamed: D3.2 (A), R7.2
unnamed: J1.1, J1.5, R1.1

Notes on the sheet:
Resistor in series with APS potentiomenter - can be shorted
PF5
To accelerator pedal and brake switch
PD7
PD6
PF3
PF10
Pins 5-12 go directly to EIM
PC3

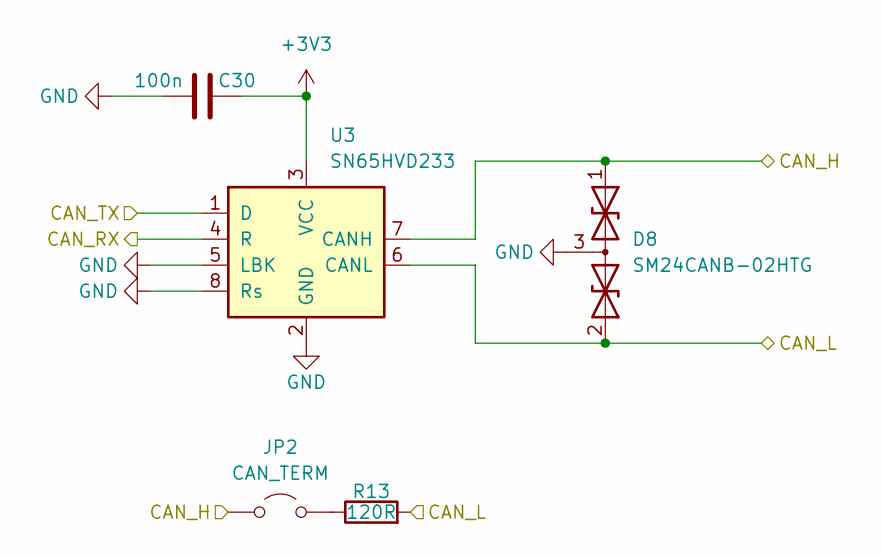
[picture p30: schematic CAN_transceiver.kicad_sch]

Parts:
C30: 100n; C_0805_2012Metric_Pad1.18x1.45mm_HandSolder
D8: SM24CANB-02HTG; SOT-23-3
JP2: CAN_TERM; PinHeader_1x02_P2.54mm_Vertical
R13: 120R; R_Axial_DIN0207_L6.3mm_D2.5mm_P10.16mm_Horizontal
U3: SN65HVD233; SOIC-8_3.9x4.9mm_P1.27mm

Connections:
+3V3: C30.2, U3.3 (VCC); also elsewhere on the board
/CANH: D8.1 (A1), JP2.1 (A), U3.7 (CANH); also elsewhere on the board
/CANL: D8.2 (A2), R13.2, U3.6 (CANL); also elsewhere on the board
/CAN_RX: U3.4 (R); also elsewhere on the board
/CAN_TX: U3.1 (D); also elsewhere on the board
GND: C30.1, D8.3 (common), U3.2 (GND), U3.5 (LBK), U3.8 (Rs); also elsewhere on the board
unnamed: JP2.2 (B), R13.1

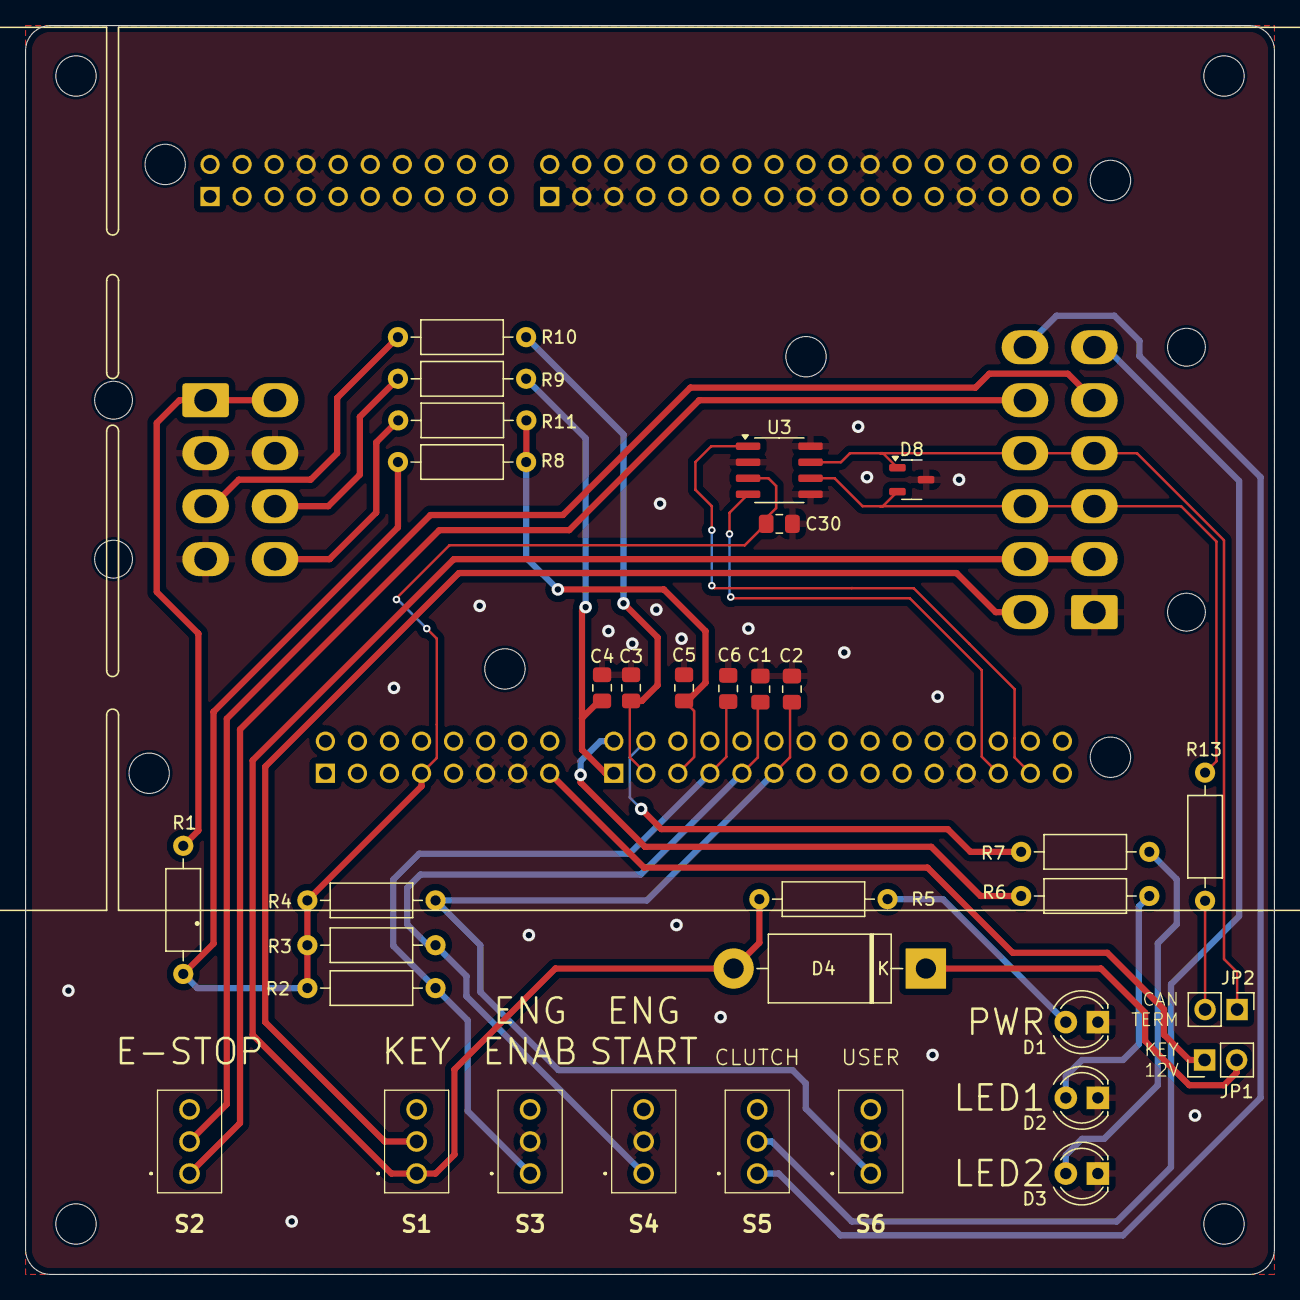
[picture p31: board temp_vcu.kicad_pcb from above]

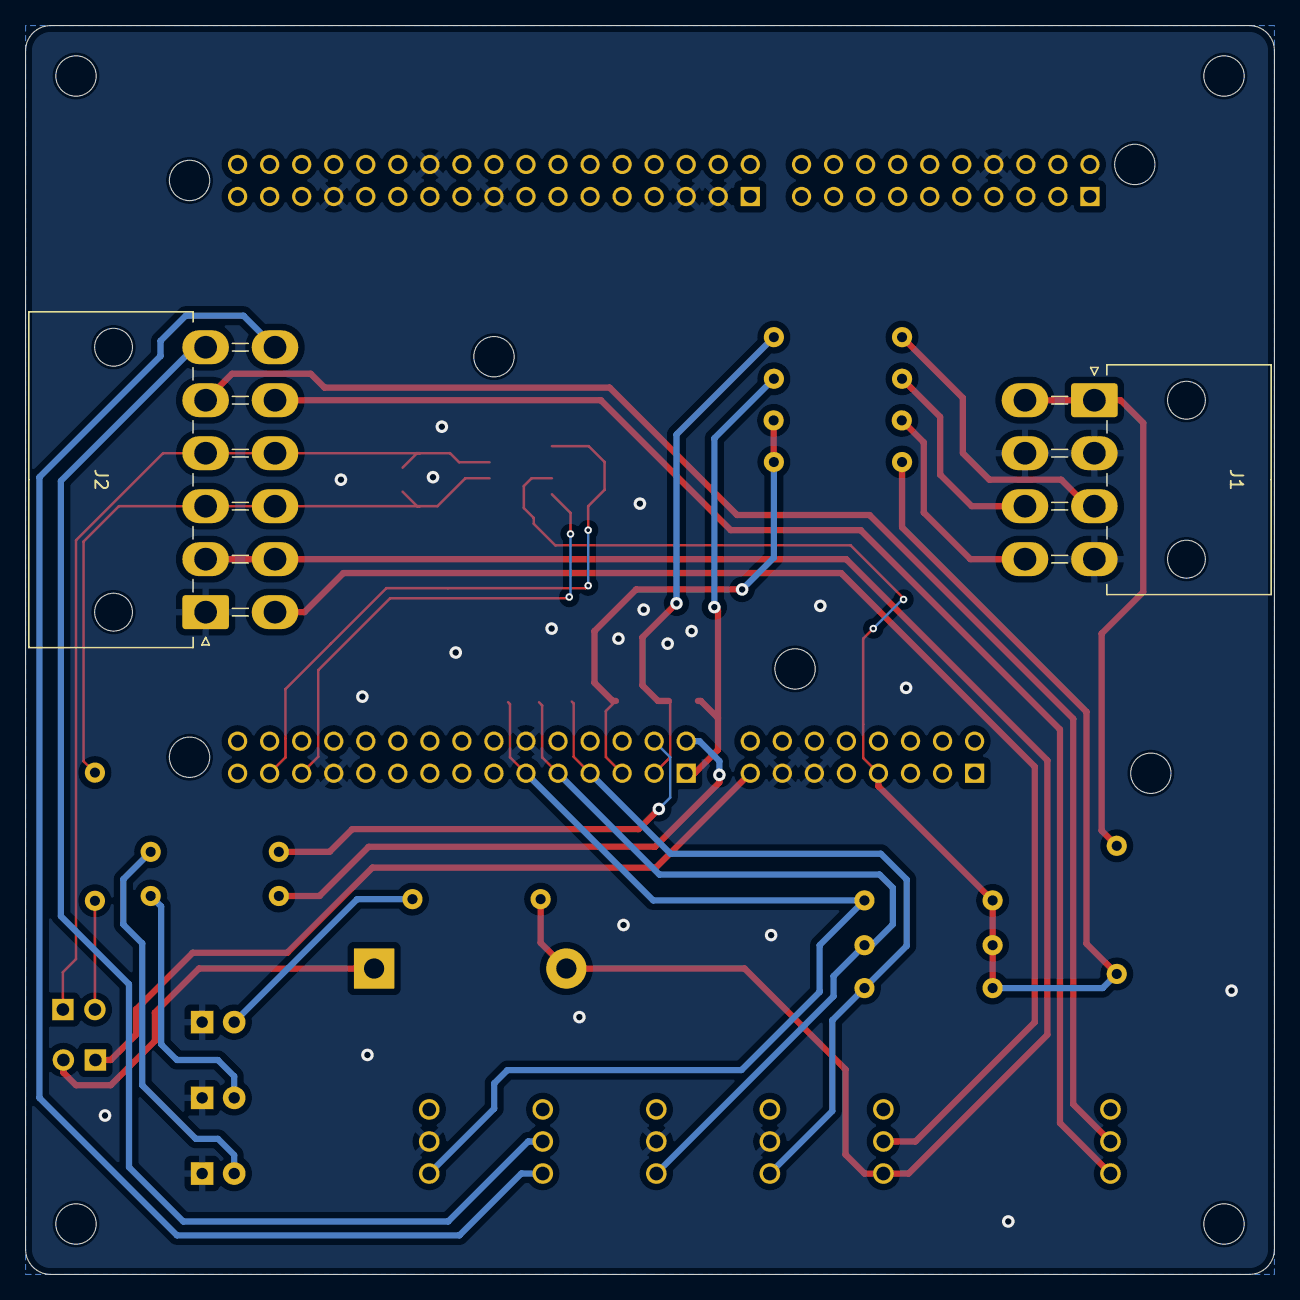
[picture p32: board temp_vcu.kicad_pcb from below]

Board: 2 copper layers, 99.0 x 99.0 mm, 36 parts (2 on the bottom side), 30 nets.
