bhorst519/bluecar/EIM/pcb/EIM/EIM.kicad_pcb

## KiCad design EIM/pcb/EIM/EIM.kicad_pcb (2025-02-19)

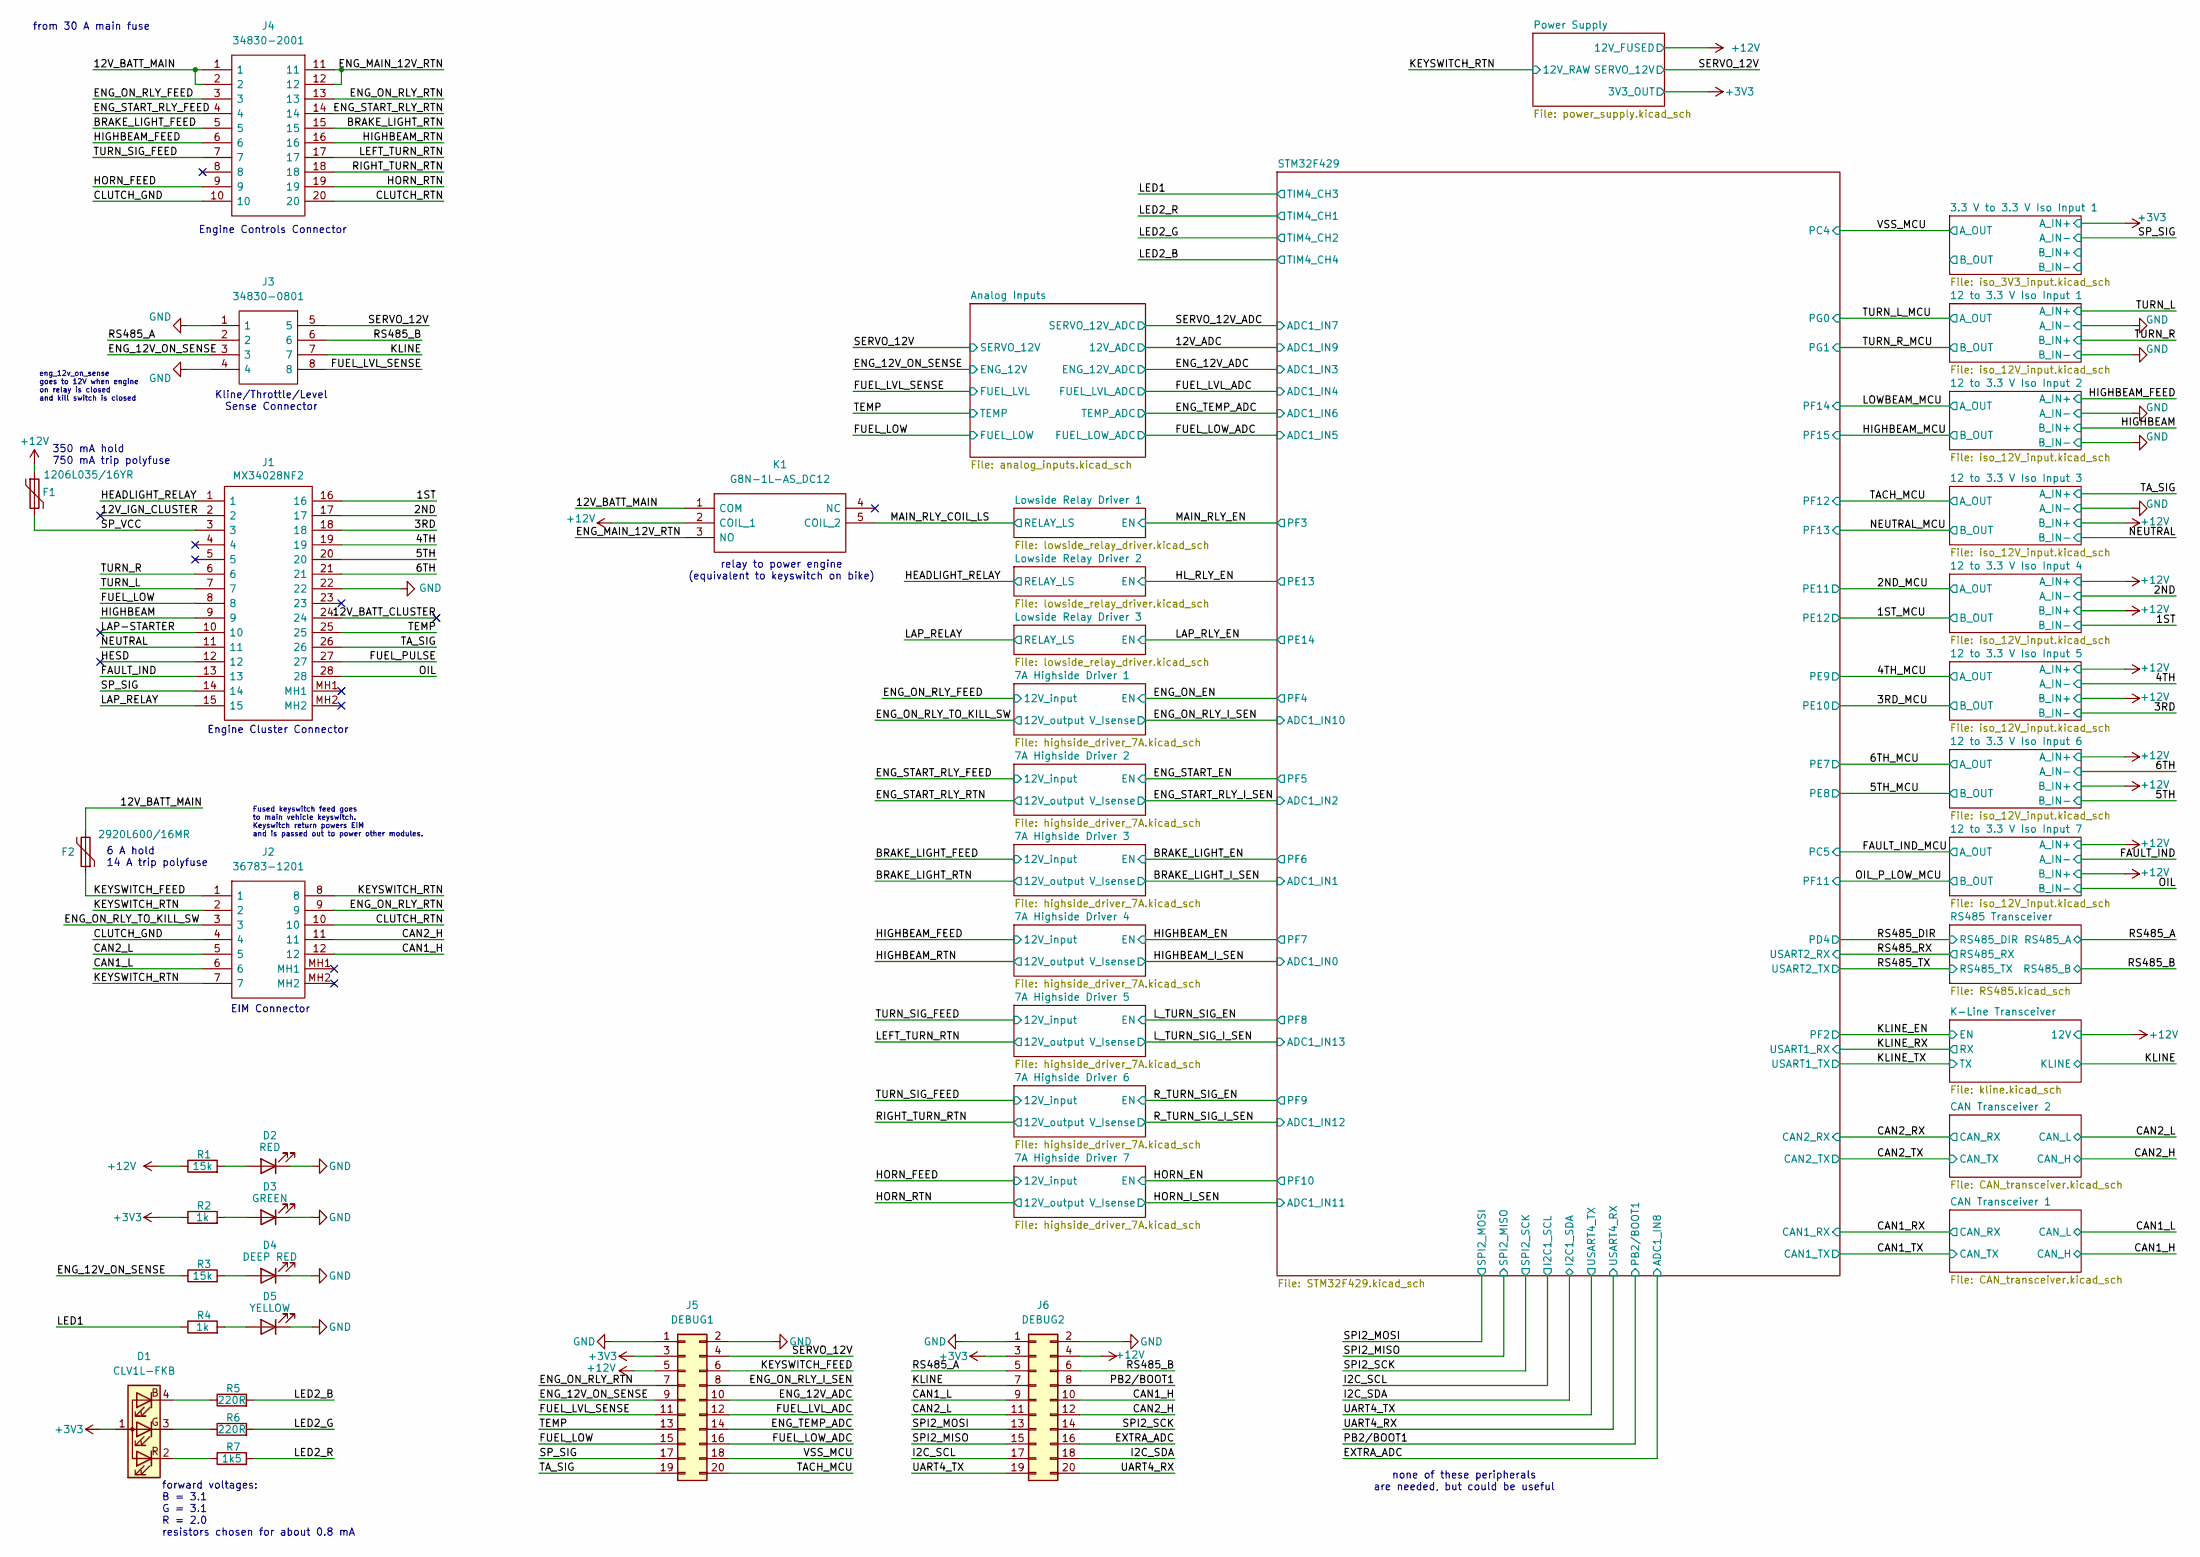
[picture p33: schematic EIM.kicad_sch]

Parts:
D1: CLV1L-FKB; LED_Cree-PLCC4_3.2x2.8mm_CCW
D2: RED; LED_0805_2012Metric
D3: GREEN; LED_0805_2012Metric
D4: DEEP RED; LED_0805_2012Metric
D5: YELLOW; LED_0805_2012Metric
F1: 1206L035/16YR; Fuse_1206_3216Metric
F2: 2920L600/16MR; Fuse_2920_7451Metric
J1: MX34028NF2; Mouser Part Number 656-MX34028NF2
J2: 36783-1201; 367831201; Mouser Part Number 538-36783-1201
J3: 34830-0801; 348300801; Mouser Part Number 538-34830-0801
J4: 34830-2001; 348302001; Mouser Part Number 538-34830-2001
J5: DEBUG1; PinHeader_2x10_P2.54mm_Vertical
J6: DEBUG2; PinHeader_2x10_P2.54mm_Vertical
K1: G8N-1L-AS_DC12; G8N1LASDC12; Mouser Part Number 653-G8N-1L-AS-DC12
R1, R3: 15k; R_0805_2012Metric_Pad1.20x1.40mm_HandSolder
R2, R4: 1k; R_0805_2012Metric_Pad1.20x1.40mm_HandSolder
R5, R6: 220R; R_0805_2012Metric_Pad1.20x1.40mm_HandSolder
R7: 1k5; R_0805_2012Metric_Pad1.20x1.40mm_HandSolder

Connections:
+3V3: D1.1 (A), J5.3, J6.3, R2.1; also elsewhere on the board
+12V: F1.1, J5.5, J6.4, K1.2 (COIL_1), R1.1; also elsewhere on the board
/1ST: J1.16; also elsewhere on the board
/2ND: J1.17; also elsewhere on the board
/3RD: J1.18; also elsewhere on the board
/4TH: J1.19; also elsewhere on the board
/5TH: J1.20; also elsewhere on the board
/6TH: J1.21; also elsewhere on the board
/12V_BATT_CLUSTER: J1.24
/12V_BATT_MAIN: F2.2, J4.1, J4.2, K1.1 (COM)
/12V_IGN_CLUSTER: J1.2
/BRAKE_LIGHT_FEED: J4.5; also elsewhere on the board
/BRAKE_LIGHT_RTN: J4.15; also elsewhere on the board
/CAN1_H: J2.12, J6.10; also elsewhere on the board
/CAN1_L: J2.6, J6.9; also elsewhere on the board
/CAN2_H: J2.11, J6.12; also elsewhere on the board
/CAN2_L: J2.5, J6.11; also elsewhere on the board
/CLUTCH_GND: J2.4, J4.10
/CLUTCH_RTN: J2.10, J4.20
/ENG_12V_ADC: J5.10; also elsewhere on the board
/ENG_12V_ON_SENSE: J3.3, J5.9, R3.1; also elsewhere on the board
/ENG_MAIN_12V_RTN: J4.11, J4.12, K1.3 (NO)
/ENG_ON_RLY_FEED: J4.3; also elsewhere on the board
/ENG_ON_RLY_I_SEN: J5.8; also elsewhere on the board
/ENG_ON_RLY_RTN: J2.9, J4.13, J5.7
/ENG_ON_RLY_TO_KILL_SW: J2.3; also elsewhere on the board
/ENG_START_RLY_FEED: J4.4; also elsewhere on the board
/ENG_START_RLY_RTN: J4.14; also elsewhere on the board
/ENG_TEMP_ADC: J5.14; also elsewhere on the board
/EXTRA_ADC: J6.16; also elsewhere on the board
/FAULT_IND: J1.13; also elsewhere on the board
/FUEL_LOW: J1.8, J5.15; also elsewhere on the board
/FUEL_LOW_ADC: J5.16; also elsewhere on the board
/FUEL_LVL_ADC: J5.12; also elsewhere on the board
/FUEL_LVL_SENSE: J3.8, J5.11; also elsewhere on the board
/FUEL_PULSE: J1.27
/HEADLIGHT_RELAY: J1.1; also elsewhere on the board
/HESD: J1.12
/HIGHBEAM: J1.9; also elsewhere on the board
/HIGHBEAM_FEED: J4.6; also elsewhere on the board
/HIGHBEAM_RTN: J4.16; also elsewhere on the board
/HORN_FEED: J4.9; also elsewhere on the board
/HORN_RTN: J4.19; also elsewhere on the board
/I2C_SCL: J6.17; also elsewhere on the board
/I2C_SDA: J6.18; also elsewhere on the board
/KEYSWITCH_FEED: F2.1, J2.1, J5.6
/KEYSWITCH_RTN: J2.2, J2.7, J2.8; also elsewhere on the board
/KLINE: J3.7, J6.7; also elsewhere on the board
/LAP-STARTER: J1.10
/LAP_RELAY: J1.15; also elsewhere on the board
/LED1: R4.1; also elsewhere on the board
/LED2_B: R5.2; also elsewhere on the board
/LED2_G: R6.2; also elsewhere on the board
/LED2_R: R7.2; also elsewhere on the board
/LEFT_TURN_RTN: J4.17; also elsewhere on the board
/MAIN_RLY_COIL_LS: K1.5 (COIL_2); also elsewhere on the board
/NEUTRAL: J1.11; also elsewhere on the board
/OIL: J1.28; also elsewhere on the board
/PB2/BOOT1: J6.8; also elsewhere on the board
/RIGHT_TURN_RTN: J4.18; also elsewhere on the board
/RS485_A: J3.2, J6.5; also elsewhere on the board
/RS485_B: J3.6, J6.6; also elsewhere on the board
/SERVO_12V: J3.5, J5.4; also elsewhere on the board
/SPI2_MISO: J6.15; also elsewhere on the board
/SPI2_MOSI: J6.13; also elsewhere on the board
/SPI2_SCK: J6.14; also elsewhere on the board
/SP_SIG: J1.14, J5.17; also elsewhere on the board
/SP_VCC: F1.2, J1.3
/TACH_MCU: J5.20; also elsewhere on the board
/TA_SIG: J1.26, J5.19; also elsewhere on the board
/TEMP: J1.25, J5.13; also elsewhere on the board
/TURN_L: J1.7; also elsewhere on the board
/TURN_R: J1.6; also elsewhere on the board
/TURN_SIG_FEED: J4.7; also elsewhere on the board
/UART4_RX: J6.20; also elsewhere on the board
/UART4_TX: J6.19; also elsewhere on the board
/VSS_MCU: J5.18; also elsewhere on the board
GND: D2.1 (K), D3.1 (K), D4.1 (K), D5.1 (K), J1.22, J3.1, J3.4, J5.1, J5.2, J6.1, J6.2; also elsewhere on the board
unnamed: D1.4 (BK), R5.1
unnamed: D1.3 (GK), R6.1
unnamed: D1.2 (RK), R7.1
unnamed: D2.2 (A), R1.2
unnamed: D3.2 (A), R2.2
unnamed: D4.2 (A), R3.2
unnamed: D5.2 (A), R4.2

Notes on the sheet:
Fused keyswitch feed goes to main vehicle keyswitch. Keyswitch return powers EIM and is passed out to power other modules.
Kline/Throttle/Level Sense Connector
eng_12v_on_sense goes to 12V when engine on relay is closed and kill switch is closed
from 30 A main fuse
none of these peripherals are needed, but could be useful
relay to power engine (equivalent to keyswitch on bike)
6 A hold 14 A trip polyfuse
forward voltages: B = 3.1 G = 3.1 R = 2.0 resistors chosen for about 0.8 mA
Engine Cluster Connector
Engine Controls Connector
EIM Connector
350 mA hold 750 mA trip polyfuse

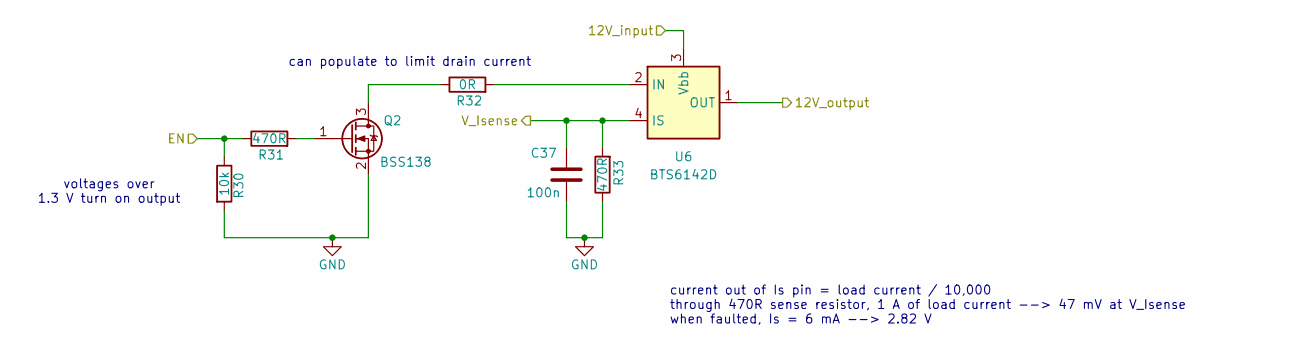
[picture p34: schematic highside_driver_7A.kicad_sch]

Parts:
C37: 100n; C_0805_2012Metric_Pad1.18x1.45mm_HandSolder
Q2: BSS138; SOT-23
R30: 10k; R_0805_2012Metric_Pad1.20x1.40mm_HandSolder
R31, R33: 470R; R_0805_2012Metric_Pad1.20x1.40mm_HandSolder
R32: 0R; R_0805_2012Metric_Pad1.20x1.40mm_HandSolder
U6: BTS6142D; TO-252-4

Connections:
/ENG_START_EN: R30.1, R31.1; also elsewhere on the board
/ENG_START_RLY_FEED: U6.3 (Vbb); also elsewhere on the board
/ENG_START_RLY_I_SEN: C37.2, R33.2, U6.4 (IS); also elsewhere on the board
/ENG_START_RLY_RTN: U6.1 (OUT), U6.5 (OUT); also elsewhere on the board
GND: C37.1, Q2.2 (S), R30.2, R33.1; also elsewhere on the board
unnamed: Q2.3 (D), R32.1
unnamed: Q2.1 (G), R31.2
unnamed: R32.2, U6.2 (IN)

Parts of its further copies:
C36, C38, C39, C40, C41, C42: 100n; C_0805_2012Metric_Pad1.18x1.45mm_HandSolder
Q1, Q3, Q4, Q5, Q6, Q7: BSS138; SOT-23
R26, R34, R38, R42, R46, R50: 10k; R_0805_2012Metric_Pad1.20x1.40mm_HandSolder
R27, R29, R35, R37, R39, R41, R43, R45, R47, R49, R51, R53: 470R; R_0805_2012Metric_Pad1.20x1.40mm_HandSolder
R28, R36, R40, R44, R48, R52: 0R; R_0805_2012Metric_Pad1.20x1.40mm_HandSolder
U5, U7, U8, U9, U10, U11: BTS6142D; TO-252-4

Connections of its further copies:
/BRAKE_LIGHT_EN: R34.1, R35.1; also elsewhere on the board
/BRAKE_LIGHT_FEED: U7.3 (Vbb); also elsewhere on the board
/BRAKE_LIGHT_I_SEN: C38.2, R37.2, U7.4 (IS); also elsewhere on the board
/BRAKE_LIGHT_RTN: U7.1 (OUT), U7.5 (OUT); also elsewhere on the board
/ENG_ON_EN: R26.1, R27.1; also elsewhere on the board
/ENG_ON_RLY_FEED: U5.3 (Vbb); also elsewhere on the board
/ENG_ON_RLY_I_SEN: C36.2, R29.2, U5.4 (IS); also elsewhere on the board
/ENG_ON_RLY_TO_KILL_SW: U5.1 (OUT), U5.5 (OUT); also elsewhere on the board
/HIGHBEAM_EN: R38.1, R39.1; also elsewhere on the board
/HIGHBEAM_FEED: U8.3 (Vbb); also elsewhere on the board
/HIGHBEAM_I_SEN: C39.2, R41.2, U8.4 (IS); also elsewhere on the board
/HIGHBEAM_RTN: U8.1 (OUT), U8.5 (OUT); also elsewhere on the board
/HORN_EN: R50.1, R51.1; also elsewhere on the board
/HORN_FEED: U11.3 (Vbb); also elsewhere on the board
/HORN_I_SEN: C42.2, R53.2, U11.4 (IS); also elsewhere on the board
/HORN_RTN: U11.1 (OUT), U11.5 (OUT); also elsewhere on the board
/LEFT_TURN_RTN: U9.1 (OUT), U9.5 (OUT); also elsewhere on the board
/L_TURN_SIG_EN: R42.1, R43.1; also elsewhere on the board
/L_TURN_SIG_I_SEN: C40.2, R45.2, U9.4 (IS); also elsewhere on the board
/RIGHT_TURN_RTN: U10.1 (OUT), U10.5 (OUT); also elsewhere on the board
/R_TURN_SIG_EN: R46.1, R47.1; also elsewhere on the board
/R_TURN_SIG_I_SEN: C41.2, R49.2, U10.4 (IS); also elsewhere on the board
/TURN_SIG_FEED: U9.3 (Vbb), U10.3 (Vbb); also elsewhere on the board
GND: C36.1, C38.1, C39.1, C40.1, C41.1, C42.1, Q1.2 (S), Q3.2 (S), Q4.2 (S), Q5.2 (S), Q6.2 (S), Q7.2 (S), R26.2, R29.1, R34.2, R37.1, R38.2, R41.1, R42.2, R45.1, R46.2, R49.1, R50.2, R53.1; also elsewhere on the board
unnamed: Q1.3 (D), R28.1
unnamed: Q1.1 (G), R27.2
unnamed: Q3.3 (D), R36.1
unnamed: Q3.1 (G), R35.2
unnamed: Q4.3 (D), R40.1
unnamed: Q4.1 (G), R39.2
unnamed: Q5.3 (D), R44.1
unnamed: Q5.1 (G), R43.2
unnamed: Q6.3 (D), R48.1
unnamed: Q6.1 (G), R47.2
unnamed: Q7.3 (D), R52.1
unnamed: Q7.1 (G), R51.2
unnamed: R28.2, U5.2 (IN)
unnamed: R36.2, U7.2 (IN)
unnamed: R40.2, U8.2 (IN)
unnamed: R44.2, U9.2 (IN)
unnamed: R48.2, U10.2 (IN)
unnamed: R52.2, U11.2 (IN)

Notes on the sheet:
voltages over 1.3 V turn on output
current out of Is pin = load current / 10,000 through 470R sense resistor, 1 A of load current --> 47 mV at V_Isense when faulted, Is = 6 mA --> 2.82 V
can populate to limit drain current

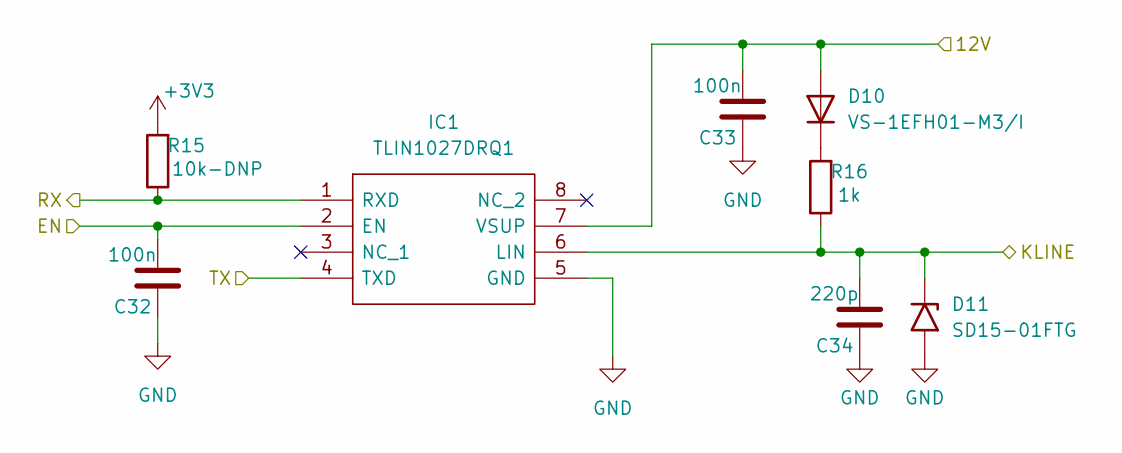
[picture p35: schematic kline.kicad_sch]

Parts:
C32, C33: 100n; C_0805_2012Metric_Pad1.18x1.45mm_HandSolder
C34: 220p; C_0805_2012Metric_Pad1.18x1.45mm_HandSolder
D10: VS-1EFH01-M3/I; D_SMF
D11: SD15-01FTG; D_SOD-323
IC1: TLIN1027DRQ1; SOIC-8_3.9x4.9mm_P1.27mm; Manufacturer_Part_Number TLIN1027DRQ1
R15: 10k-DNP; R_0805_2012Metric_Pad1.20x1.40mm_HandSolder
R16: 1k; R_0805_2012Metric_Pad1.20x1.40mm_HandSolder

Connections:
+3V3: R15.2; also elsewhere on the board
+12V: C33.1, D10.2 (A), IC1.7 (VSUP); also elsewhere on the board
/KLINE: C34.1, D11.1 (A1), IC1.6 (LIN), R16.1; also elsewhere on the board
/KLINE_EN: C32.1, IC1.2 (EN); also elsewhere on the board
/KLINE_RX: IC1.1 (RXD), R15.1; also elsewhere on the board
/KLINE_TX: IC1.4 (TXD); also elsewhere on the board
GND: C32.2, C33.2, C34.2, D11.2 (A2), IC1.5 (GND); also elsewhere on the board
unnamed: D10.1 (K), R16.2

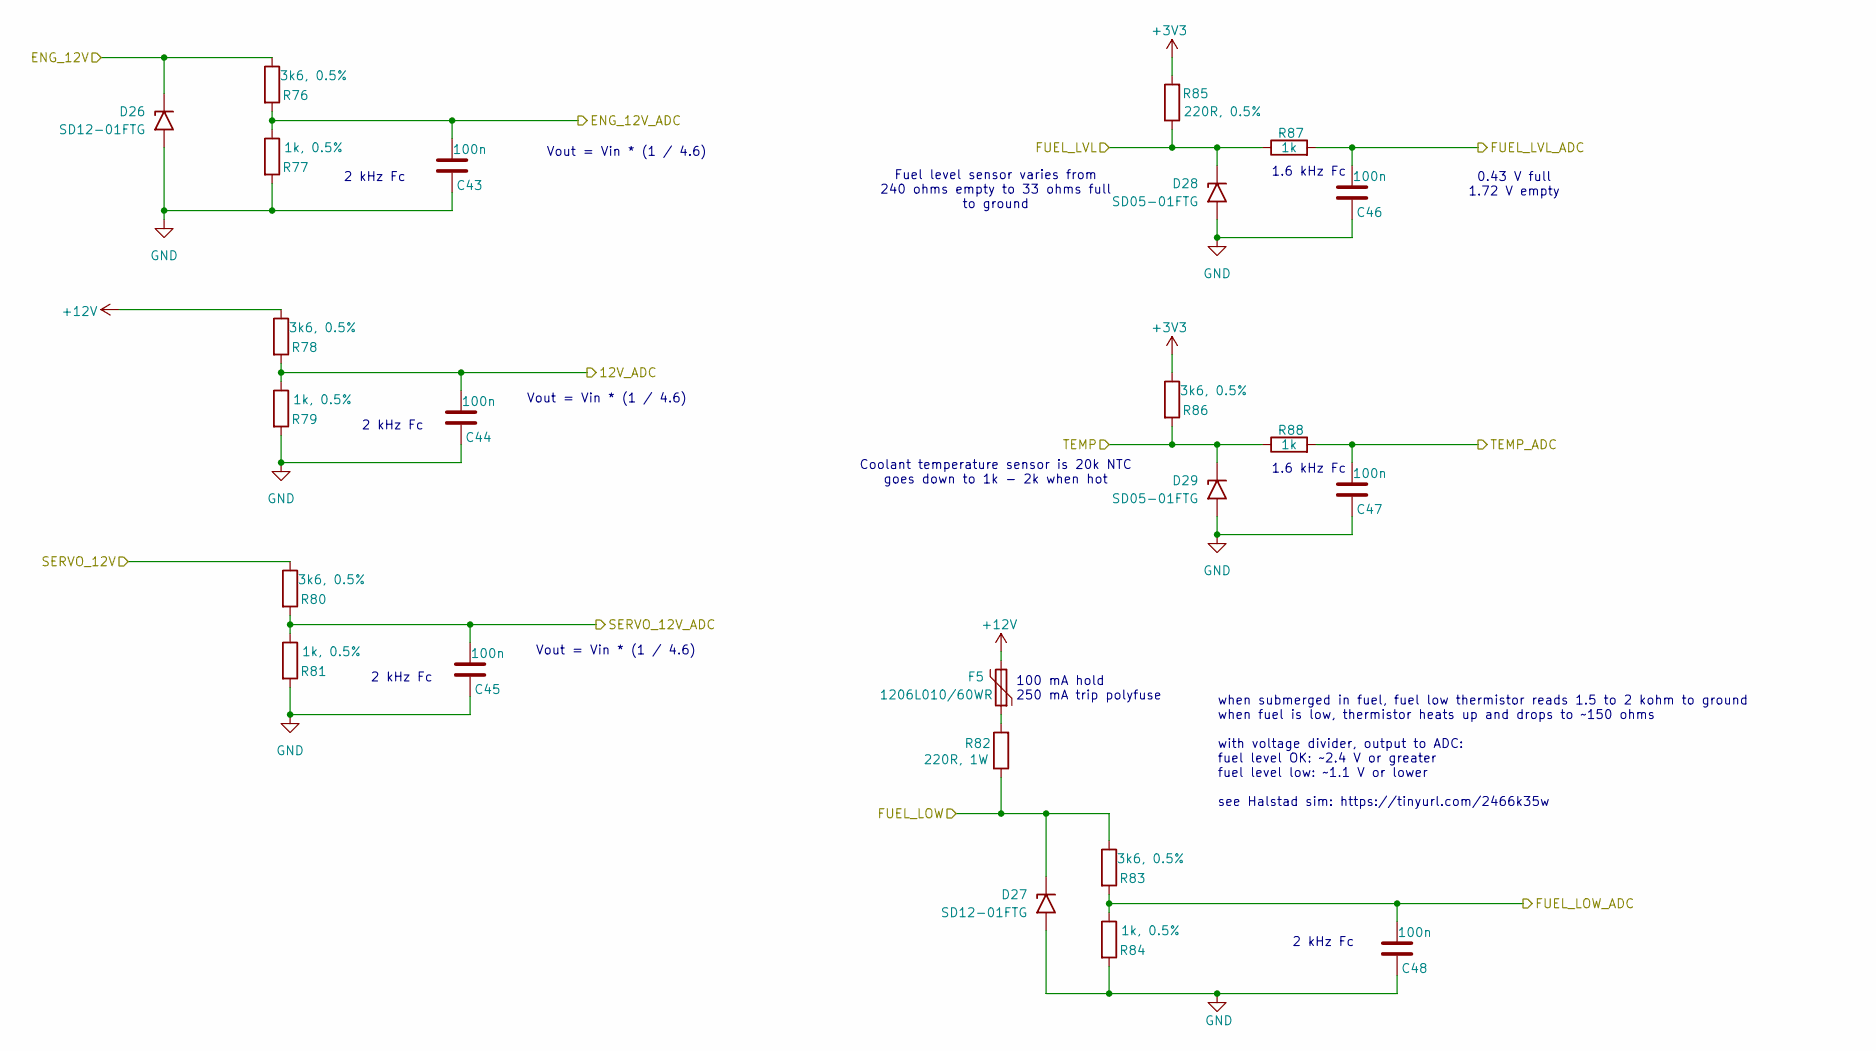
[picture p36: schematic analog_inputs.kicad_sch]

Parts:
C43, C44, C45, C46, C47, C48: 100n; C_0805_2012Metric_Pad1.18x1.45mm_HandSolder
D26, D27: SD12-01FTG; D_SOD-323
D28, D29: SD05-01FTG; D_SOD-323
F5: 1206L010/60WR; Fuse_1206_3216Metric
R76, R78, R80, R83, R86: 3k6, 0.5%; R_0805_2012Metric_Pad1.20x1.40mm_HandSolder
R77, R79, R81, R84: 1k, 0.5%; R_0805_2012Metric_Pad1.20x1.40mm_HandSolder
R82: 220R, 1W; R_2512_6332Metric
R85: 220R, 0.5%; R_0805_2012Metric_Pad1.20x1.40mm_HandSolder
R87, R88: 1k; R_0805_2012Metric_Pad1.20x1.40mm_HandSolder

Connections:
+3V3: R85.2, R86.1; also elsewhere on the board
+12V: F5.2, R78.1; also elsewhere on the board
/12V_ADC: C44.1, R78.2, R79.1; also elsewhere on the board
/ENG_12V_ADC: C43.1, R76.2, R77.1; also elsewhere on the board
/ENG_12V_ON_SENSE: D26.1 (A1), R76.1; also elsewhere on the board
/ENG_TEMP_ADC: C47.1, R88.2; also elsewhere on the board
/FUEL_LOW: D27.1 (A1), R82.1, R83.1; also elsewhere on the board
/FUEL_LOW_ADC: C48.1, R83.2, R84.1; also elsewhere on the board
/FUEL_LVL_ADC: C46.1, R87.2; also elsewhere on the board
/FUEL_LVL_SENSE: D28.1 (A1), R85.1, R87.1; also elsewhere on the board
/SERVO_12V: R80.1; also elsewhere on the board
/SERVO_12V_ADC: C45.1, R80.2, R81.1; also elsewhere on the board
/TEMP: D29.1 (A1), R86.2, R88.1; also elsewhere on the board
GND: C43.2, C44.2, C45.2, C46.2, C47.2, C48.2, D26.2 (A2), D27.2 (A2), D28.2 (A2), D29.2 (A2), R77.2, R79.2, R81.2, R84.2; also elsewhere on the board
unnamed: F5.1, R82.2

Notes on the sheet:
2 kHz Fc
Vout = Vin * (1 / 4.6)
1.6 kHz Fc
0.43 V full 1.72 V empty
Coolant temperature sensor is 20k NTC goes down to 1k - 2k when hot
when submerged in fuel, fuel low thermistor reads 1.5 to 2 kohm to ground when fuel is low, thermistor heats up and drops to ~150 ohms with voltage divider, output to ADC: fuel level OK: ~2.4 V or greater fuel level low: ~1.1 V or lower see Halstad sim: https://tinyurl.com/2466k35w
Fuel level sensor varies from 240 ohms empty to 33 ohms full to ground
100 mA hold 250 mA trip polyfuse
