bhorst519/bluecar/EIM/pcb/EIM/EIM.kicad_pcb

## KiCad design EIM/pcb/EIM/EIM.kicad_pcb (continued)

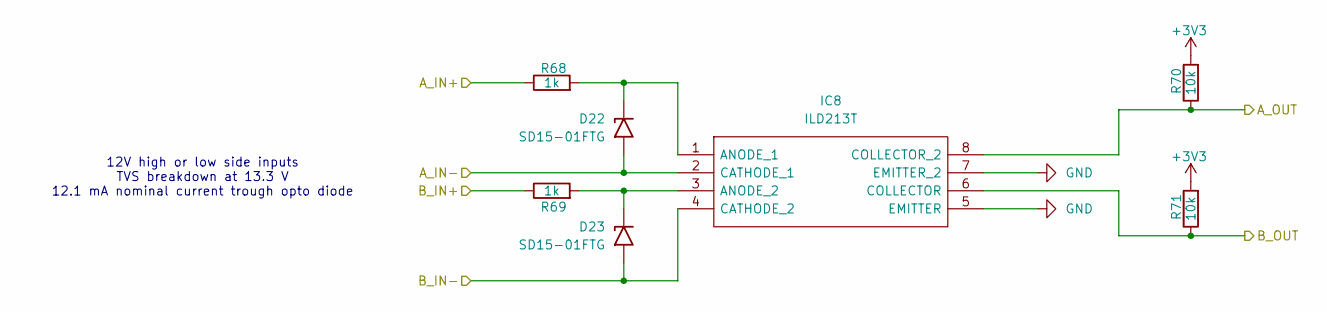
[picture p37: schematic iso_12V_input.kicad_sch]

Parts:
D22, D23: SD15-01FTG; D_SOD-323
IC8: ILD213T; SOIC127P610X350-8N; Mouser Part Number 782-ILD213T
R68, R69: 1k; R_0805_2012Metric_Pad1.20x1.40mm_HandSolder
R70, R71: 10k; R_0805_2012Metric_Pad1.20x1.40mm_HandSolder

Connections:
+3V3: R70.2, R71.2; also elsewhere on the board
+12V: R68.1, R69.1; also elsewhere on the board
/5TH: D23.2 (A2), IC8.4 (CATHODE_2); also elsewhere on the board
/5TH_MCU: IC8.6 (COLLECTOR), R71.1; also elsewhere on the board
/6TH: D22.2 (A2), IC8.2 (CATHODE_1); also elsewhere on the board
/6TH_MCU: IC8.8 (COLLECTOR_2), R70.1; also elsewhere on the board
GND: IC8.5 (EMITTER), IC8.7 (EMITTER_2); also elsewhere on the board
unnamed: D22.1 (A1), IC8.1 (ANODE_1), R68.2
unnamed: D23.1 (A1), IC8.3 (ANODE_2), R69.2

Parts of its further copies:
D13, D14, D16, D17, D18, D19, D20, D21, D24, D25, D30, D31: SD15-01FTG; D_SOD-323
IC3, IC5, IC6, IC7, IC9, IC10: ILD213T; SOIC127P610X350-8N; Mouser Part Number 782-ILD213T
R22, R23, R56, R57, R60, R61, R64, R65, R72, R73, R89, R90: 1k; R_0805_2012Metric_Pad1.20x1.40mm_HandSolder
R24, R25, R58, R59, R62, R63, R66, R67, R74, R75, R91, R92: 10k; R_0805_2012Metric_Pad1.20x1.40mm_HandSolder

Connections of its further copies:
+3V3: R24.2, R25.2, R58.2, R59.2, R62.2, R63.2, R66.2, R67.2, R74.2, R75.2, R91.2, R92.2; also elsewhere on the board
+12V: R23.1, R60.1, R61.1, R64.1, R65.1, R72.1, R73.1; also elsewhere on the board
/1ST: D19.2 (A2), IC6.4 (CATHODE_2); also elsewhere on the board
/1ST_MCU: IC6.6 (COLLECTOR), R63.1; also elsewhere on the board
/2ND: D18.2 (A2), IC6.2 (CATHODE_1); also elsewhere on the board
/2ND_MCU: IC6.8 (COLLECTOR_2), R62.1; also elsewhere on the board
/3RD: D21.2 (A2), IC7.4 (CATHODE_2); also elsewhere on the board
/3RD_MCU: IC7.6 (COLLECTOR), R67.1; also elsewhere on the board
/4TH: D20.2 (A2), IC7.2 (CATHODE_1); also elsewhere on the board
/4TH_MCU: IC7.8 (COLLECTOR_2), R66.1; also elsewhere on the board
/FAULT_IND: D24.2 (A2), IC9.2 (CATHODE_1); also elsewhere on the board
/FAULT_IND_MCU: IC9.8 (COLLECTOR_2), R74.1; also elsewhere on the board
/HIGHBEAM: R90.1; also elsewhere on the board
/HIGHBEAM_FEED: R89.1; also elsewhere on the board
/HIGHBEAM_MCU: IC10.6 (COLLECTOR), R92.1; also elsewhere on the board
/LOWBEAM_MCU: IC10.8 (COLLECTOR_2), R91.1; also elsewhere on the board
/NEUTRAL: D14.2 (A2), IC3.4 (CATHODE_2); also elsewhere on the board
/NEUTRAL_MCU: IC3.6 (COLLECTOR), R25.1; also elsewhere on the board
/OIL: D25.2 (A2), IC9.4 (CATHODE_2); also elsewhere on the board
/OIL_P_LOW_MCU: IC9.6 (COLLECTOR), R75.1; also elsewhere on the board
/TACH_MCU: IC3.8 (COLLECTOR_2), R24.1; also elsewhere on the board
/TA_SIG: R22.1; also elsewhere on the board
/TURN_L: R56.1; also elsewhere on the board
/TURN_L_MCU: IC5.8 (COLLECTOR_2), R58.1; also elsewhere on the board
/TURN_R: R57.1; also elsewhere on the board
/TURN_R_MCU: IC5.6 (COLLECTOR), R59.1; also elsewhere on the board
GND: D13.2 (A2), D16.2 (A2), D17.2 (A2), D30.2 (A2), D31.2 (A2), IC3.2 (CATHODE_1), IC3.5 (EMITTER), IC3.7 (EMITTER_2), IC5.2 (CATHODE_1), IC5.4 (CATHODE_2), IC5.5 (EMITTER), IC5.7 (EMITTER_2), IC6.5 (EMITTER), IC6.7 (EMITTER_2), IC7.5 (EMITTER), IC7.7 (EMITTER_2), IC9.5 (EMITTER), IC9.7 (EMITTER_2), IC10.2 (CATHODE_1), IC10.4 (CATHODE_2), IC10.5 (EMITTER), IC10.7 (EMITTER_2); also elsewhere on the board
unnamed: D13.1 (A1), IC3.1 (ANODE_1), R22.2
unnamed: D14.1 (A1), IC3.3 (ANODE_2), R23.2
unnamed: D16.1 (A1), IC5.1 (ANODE_1), R56.2
unnamed: D17.1 (A1), IC5.3 (ANODE_2), R57.2
unnamed: D18.1 (A1), IC6.1 (ANODE_1), R60.2
unnamed: D19.1 (A1), IC6.3 (ANODE_2), R61.2
unnamed: D20.1 (A1), IC7.1 (ANODE_1), R64.2
unnamed: D21.1 (A1), IC7.3 (ANODE_2), R65.2
unnamed: D24.1 (A1), IC9.1 (ANODE_1), R72.2
unnamed: D25.1 (A1), IC9.3 (ANODE_2), R73.2
unnamed: D30.1 (A1), IC10.1 (ANODE_1), R89.2
unnamed: D31.1 (A1), IC10.3 (ANODE_2), R90.2

Notes on the sheet:
12V high or low side inputs TVS breakdown at 13.3 V 12.1 mA nominal current trough opto diode

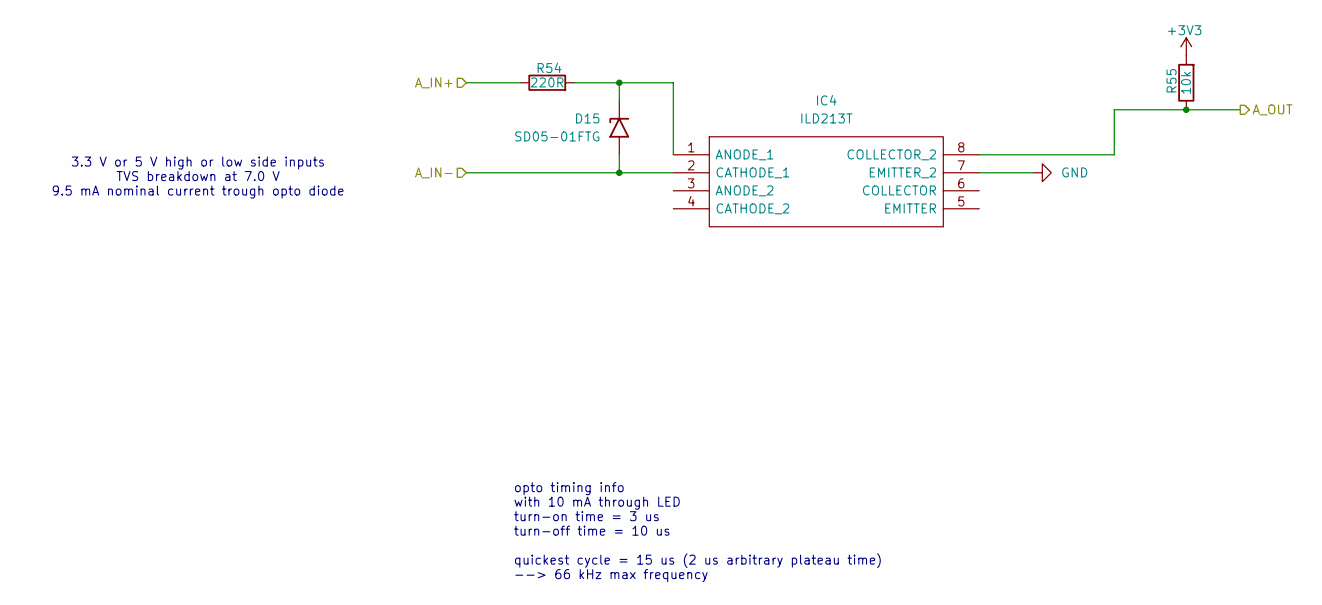
[picture p38: schematic iso_3V3_input.kicad_sch]

Parts:
D15: SD05-01FTG; D_SOD-323
IC4: ILD213T; SOIC127P610X350-8N; Mouser Part Number 782-ILD213T
R54: 220R; R_0805_2012Metric_Pad1.20x1.40mm_HandSolder
R55: 10k; R_0805_2012Metric_Pad1.20x1.40mm_HandSolder

Connections:
+3V3: R54.1, R55.2; also elsewhere on the board
/SP_SIG: D15.2 (A2), IC4.2 (CATHODE_1); also elsewhere on the board
/VSS_MCU: IC4.8 (COLLECTOR_2), R55.1; also elsewhere on the board
GND: IC4.7 (EMITTER_2); also elsewhere on the board
unnamed: D15.1 (A1), IC4.1 (ANODE_1), R54.2

Notes on the sheet:
3.3 V or 5 V high or low side inputs TVS breakdown at 7.0 V 9.5 mA nominal current trough opto diode
opto timing info with 10 mA through LED turn-on time = 3 us turn-off time = 10 us quickest cycle = 15 us (2 us arbitrary plateau time) --> 66 kHz max frequency

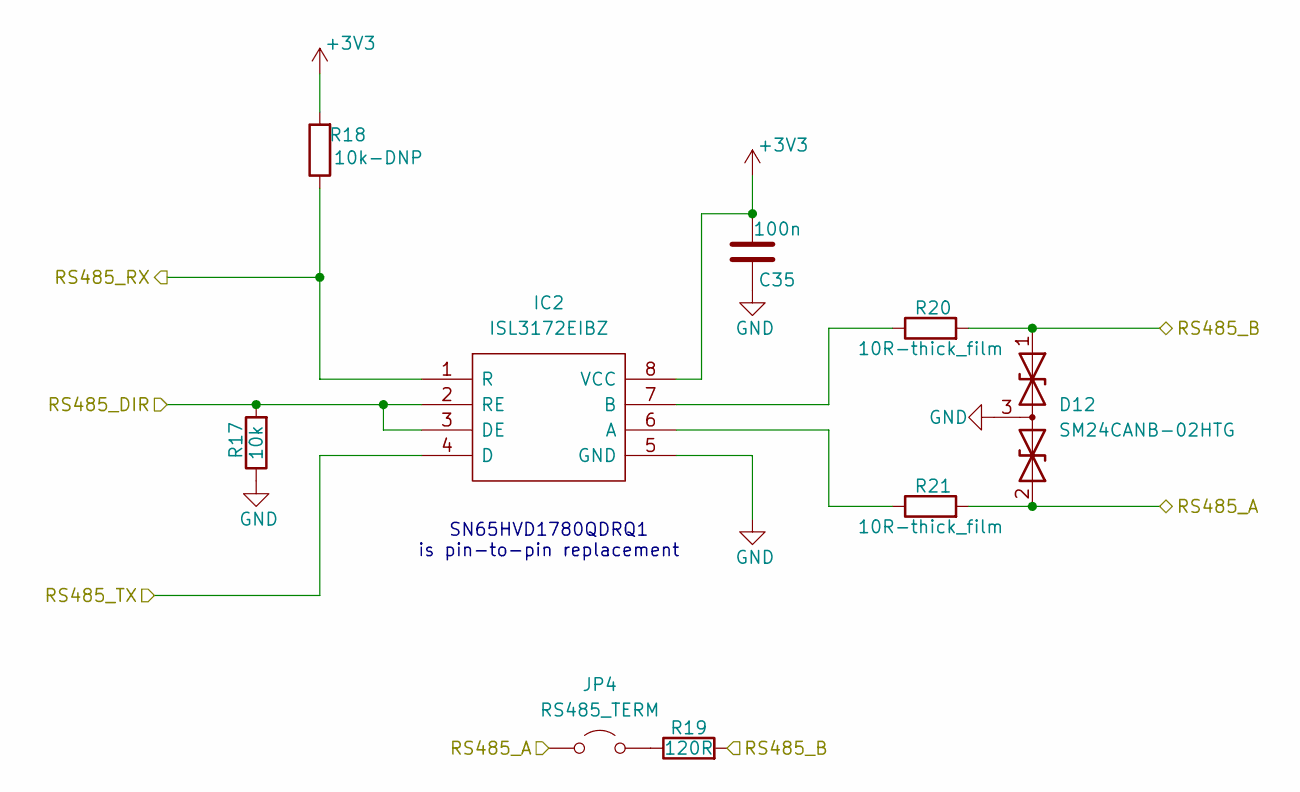
[picture p39: schematic RS485.kicad_sch]

Parts:
C35: 100n; C_0805_2012Metric_Pad1.18x1.45mm_HandSolder
D12: SM24CANB-02HTG; SOT-23-3
IC2: ISL3172EIBZ; SOIC-8_3.9x4.9mm_P1.27mm; Mouser Part Number 595-SN65HVD1780QDRQ1
JP4: RS485_TERM; SolderJumper-2_P1.3mm_Bridged_RoundedPad1.0x1.5mm
R17: 10k; R_0805_2012Metric_Pad1.20x1.40mm_HandSolder
R18: 10k-DNP; R_0805_2012Metric_Pad1.20x1.40mm_HandSolder
R19: 120R; R_0805_2012Metric_Pad1.20x1.40mm_HandSolder
R20, R21: 10R-thick_film; R_0805_2012Metric_Pad1.20x1.40mm_HandSolder

Connections:
+3V3: C35.1, IC2.8 (VCC), R18.2; also elsewhere on the board
/RS485_A: D12.2 (A2), JP4.1 (A), R21.2; also elsewhere on the board
/RS485_B: D12.1 (A1), R19.2, R20.2; also elsewhere on the board
/RS485_DIR: IC2.2 (RE), IC2.3 (DE), R17.2; also elsewhere on the board
/RS485_RX: IC2.1 (R), R18.1; also elsewhere on the board
/RS485_TX: IC2.4 (D); also elsewhere on the board
GND: C35.2, D12.3 (common), IC2.5 (GND), R17.1; also elsewhere on the board
unnamed: IC2.6 (A), R21.1
unnamed: IC2.7 (B), R20.1
unnamed: JP4.2 (B), R19.1

Notes on the sheet:
SN65HVD1780QDRQ1 is pin-to-pin replacement

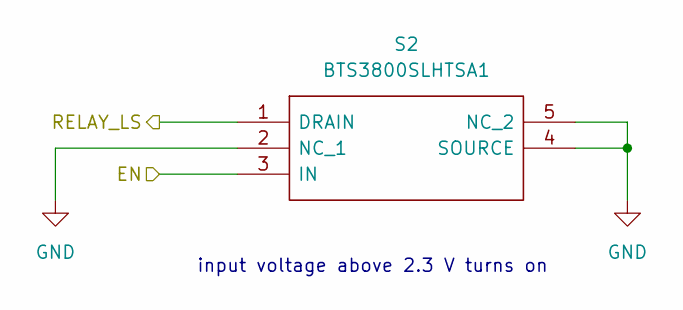
[picture p40: schematic lowside_relay_driver.kicad_sch]

Parts:
S2: BTS3800SLHTSA1; Mouser Part Number 726-BTS3800SLHTSA1

Connections:
/HEADLIGHT_RELAY: S2.1 (DRAIN); also elsewhere on the board
/HL_RLY_EN: S2.3 (IN); also elsewhere on the board
GND: S2.2 (NC_1), S2.4 (SOURCE), S2.5 (NC_2); also elsewhere on the board

Parts of its further copies:
S1, S3: BTS3800SLHTSA1; Mouser Part Number 726-BTS3800SLHTSA1

Connections of its further copies:
/LAP_RELAY: S3.1 (DRAIN); also elsewhere on the board
/LAP_RLY_EN: S3.3 (IN); also elsewhere on the board
/MAIN_RLY_COIL_LS: S1.1 (DRAIN); also elsewhere on the board
/MAIN_RLY_EN: S1.3 (IN); also elsewhere on the board
GND: S1.2 (NC_1), S1.4 (SOURCE), S1.5 (NC_2), S3.2 (NC_1), S3.4 (SOURCE), S3.5 (NC_2); also elsewhere on the board

Notes on the sheet:
input voltage above 2.3 V turns on


Parts:
C30: 100n; C_0805_2012Metric_Pad1.18x1.45mm_HandSolder
D8: SM24CANB-02HTG; SOT-23-3
JP2: CAN_TERM; SolderJumper-2_P1.3mm_Open_RoundedPad1.0x1.5mm
R13: 120R; R_0805_2012Metric_Pad1.20x1.40mm_HandSolder
U3: SN65HVD233; SOIC-8_3.9x4.9mm_P1.27mm

Connections:
+3V3: C30.2, U3.3 (VCC); also elsewhere on the board
/CAN1_H: D8.1 (A1), JP2.1 (A), U3.7 (CANH); also elsewhere on the board
/CAN1_L: D8.2 (A2), R13.2, U3.6 (CANL); also elsewhere on the board
/CAN1_RX: U3.4 (R); also elsewhere on the board
/CAN1_TX: U3.1 (D); also elsewhere on the board
GND: C30.1, D8.3 (common), U3.2 (GND), U3.5 (LBK), U3.8 (Rs); also elsewhere on the board
unnamed: JP2.2 (B), R13.1

Parts of its further copies:
C31: 100n; C_0805_2012Metric_Pad1.18x1.45mm_HandSolder
D9: SM24CANB-02HTG; SOT-23-3
JP3: CAN_TERM; SolderJumper-2_P1.3mm_Open_RoundedPad1.0x1.5mm
R14: 120R; R_0805_2012Metric_Pad1.20x1.40mm_HandSolder
U4: SN65HVD233; SOIC-8_3.9x4.9mm_P1.27mm

Connections of its further copies:
+3V3: C31.2, U4.3 (VCC); also elsewhere on the board
/CAN2_H: D9.1 (A1), JP3.1 (A), U4.7 (CANH); also elsewhere on the board
/CAN2_L: D9.2 (A2), R14.2, U4.6 (CANL); also elsewhere on the board
/CAN2_RX: U4.4 (R); also elsewhere on the board
/CAN2_TX: U4.1 (D); also elsewhere on the board
GND: C31.1, D9.3 (common), U4.2 (GND), U4.5 (LBK), U4.8 (Rs); also elsewhere on the board
unnamed: JP3.2 (B), R14.1

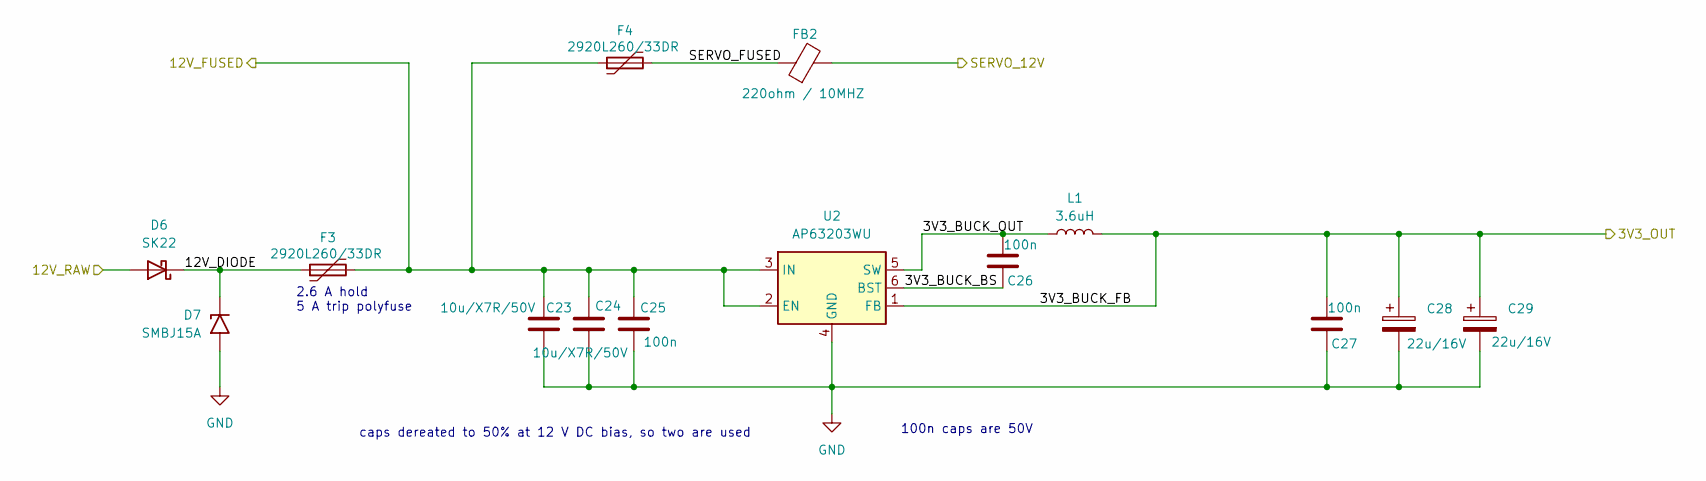
[picture p41: schematic power_supply.kicad_sch]

Parts:
C23, C24: 10u/X7R/50V; C_1206_3216Metric_Pad1.33x1.80mm_HandSolder
C25, C26, C27: 100n; C_0805_2012Metric_Pad1.18x1.45mm_HandSolder
C28, C29: 22u/16V; CP_Elec_4x5.8
D6: SK22; D_SMB
D7: SMBJ15A; D_SMB
F3, F4: 2920L260/33DR; Fuse_2920_7451Metric
FB2: 220ohm / 10MHZ; L_0805_2012Metric_Pad1.15x1.40mm_HandSolder
L1: 3.6uH; L_Bourns-SRN8040_8x8.15mm
U2: AP63203WU; TSOT-23-6

Connections:
+3V3: C27.1, C28.1, C29.1, L1.2, U2.1 (FB); also elsewhere on the board
+12V: C23.2, C24.2, C25.1, F3.2, F4.1, U2.2 (EN), U2.3 (IN); also elsewhere on the board
/KEYSWITCH_RTN: D6.2 (A); also elsewhere on the board
/Power Supply/3V3_BUCK_BS: C26.2, U2.6 (BST)
/Power Supply/3V3_BUCK_OUT: C26.1, L1.1, U2.5 (SW)
/Power Supply/12V_DIODE: D6.1 (K), D7.1 (A1), F3.1
/Power Supply/SERVO_FUSED: F4.2, FB2.1
/SERVO_12V: FB2.2; also elsewhere on the board
GND: C23.1, C24.1, C25.2, C27.2, C28.2, C29.2, D7.2 (A2), U2.4 (GND); also elsewhere on the board

Notes on the sheet:
100n caps are 50V
2.6 A hold 5 A trip polyfuse
caps dereated to 50% at 12 V DC bias, so two are used

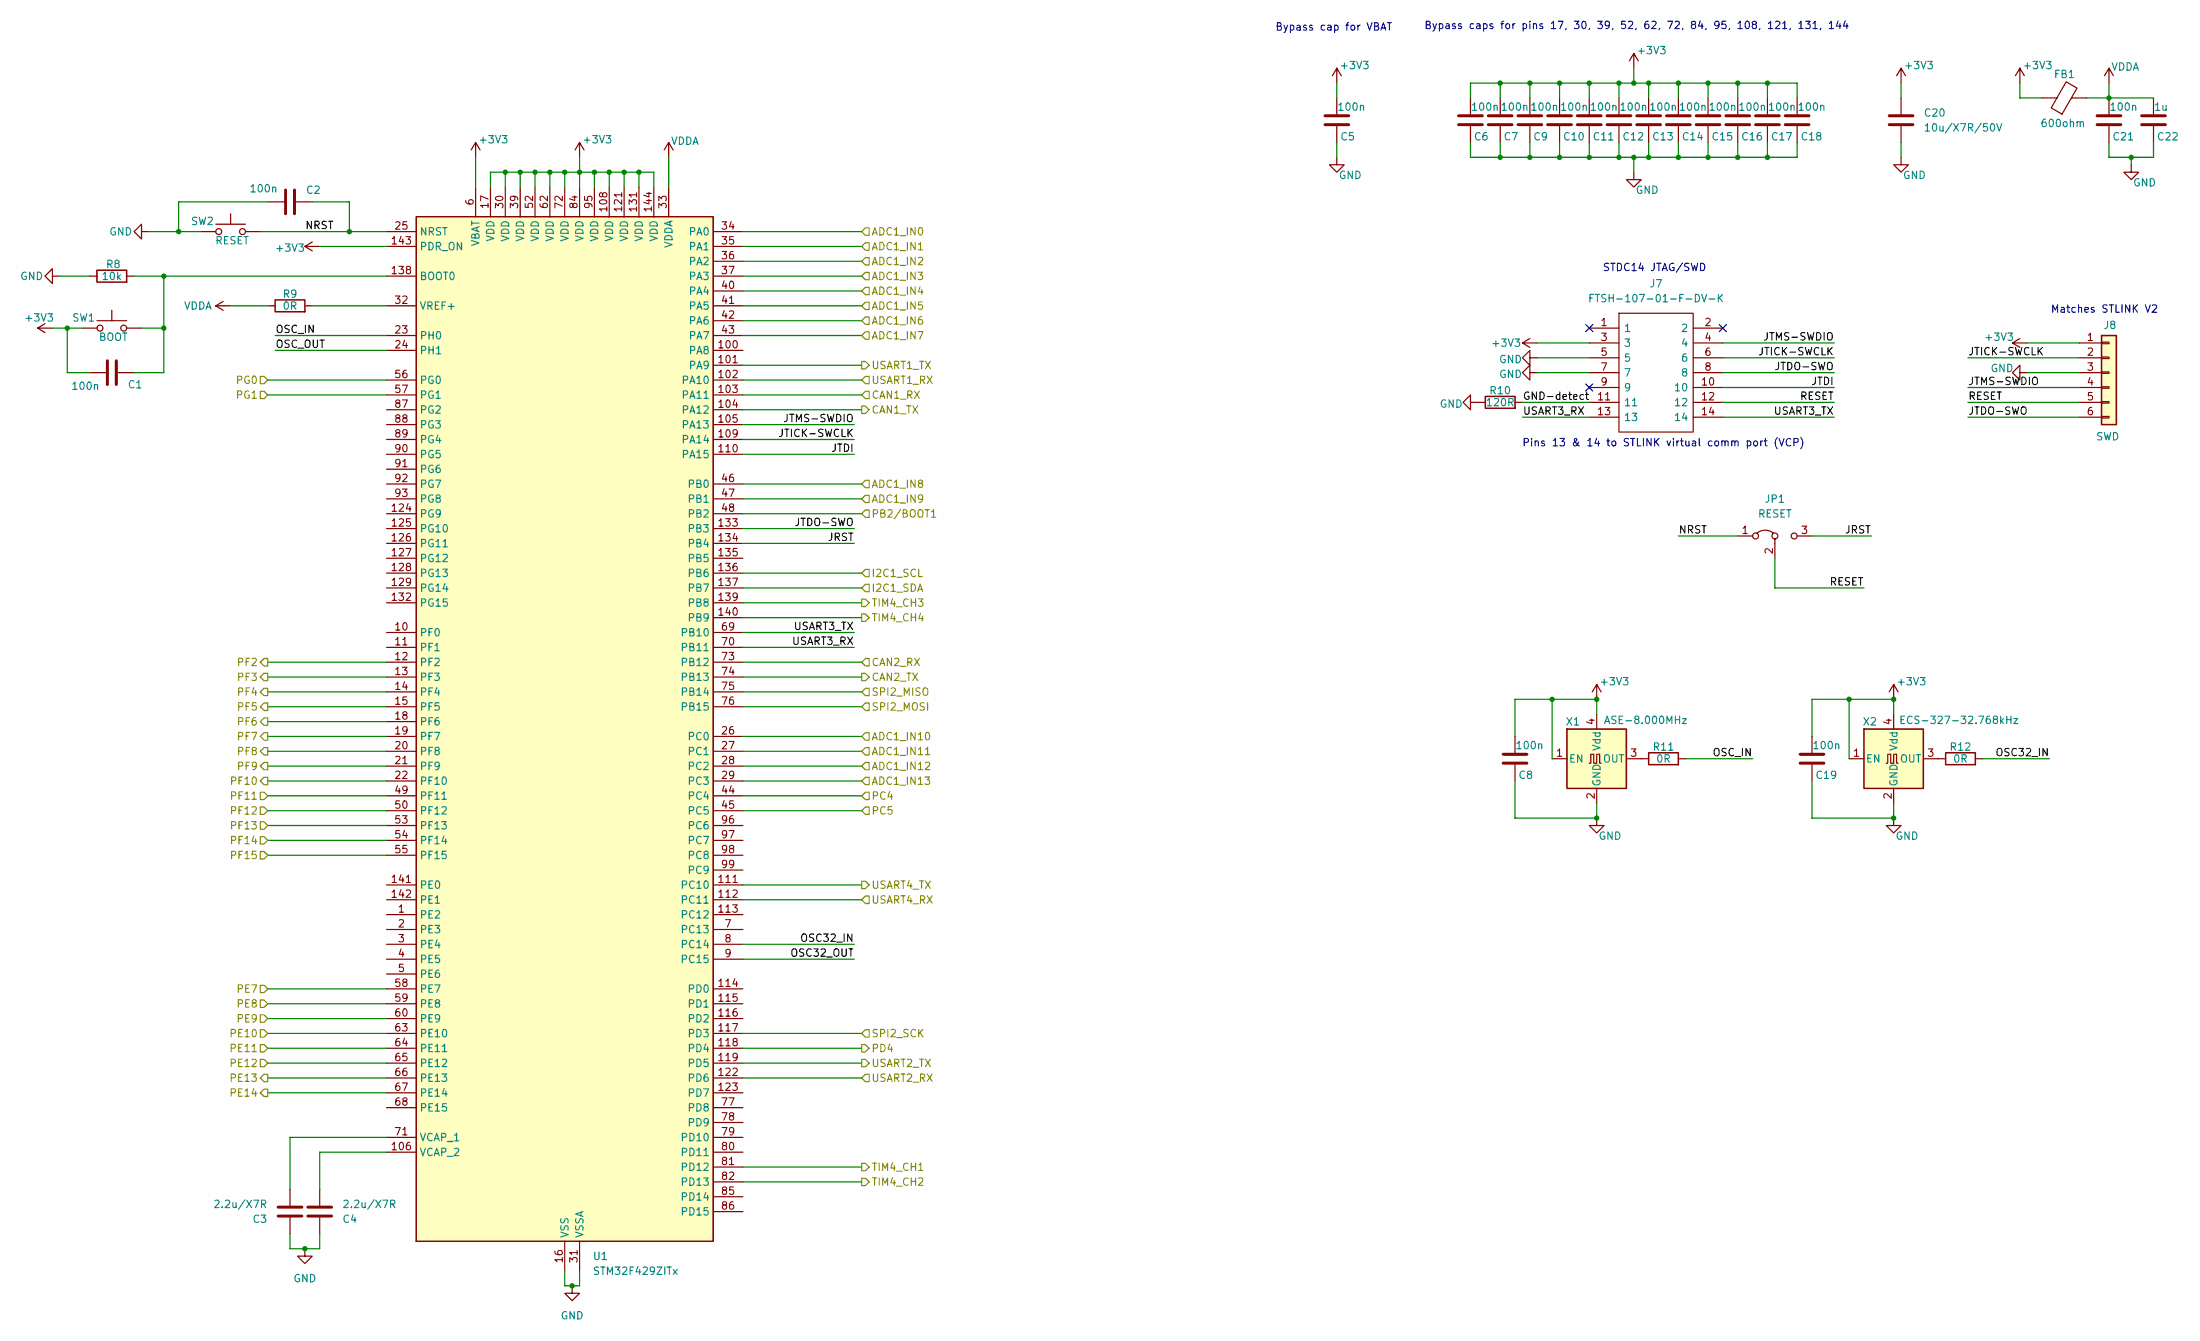
[picture p42: schematic STM32F429.kicad_sch]

Parts:
C1, C2, C5, C6, C7, C8, C9, C10, C11, C12, C13, C14, C15, C16, C17, C18, C19, C21: 100n; C_0805_2012Metric_Pad1.18x1.45mm_HandSolder
C3, C4: 2.2u/X7R; C_1206_3216Metric_Pad1.33x1.80mm_HandSolder
C20: 10u/X7R/50V; C_1206_3216Metric_Pad1.33x1.80mm_HandSolder
C22: 1u; C_0805_2012Metric_Pad1.18x1.45mm_HandSolder
FB1: 600ohm; L_0805_2012Metric_Pad1.15x1.40mm_HandSolder
J7: FTSH-107-01-F-DV-K; FTSH-107-XX-YYY-DV-K; Mouser Part Number 200-FTSH10701FDVK
J8: SWD; PinHeader_1x06_P2.54mm_Vertical
JP1: RESET; SolderJumper-3_P1.3mm_Bridged12_RoundedPad1.0x1.5mm
R8: 10k; R_0805_2012Metric_Pad1.20x1.40mm_HandSolder
R9, R11, R12: 0R; R_0805_2012Metric_Pad1.20x1.40mm_HandSolder
R10: 120R; R_0805_2012Metric_Pad1.20x1.40mm_HandSolder
SW1: BOOT; SW_SPST_PTS645
SW2: RESET; SW_SPST_PTS645
U1: STM32F429ZITx; LQFP-144_20x20mm_P0.5mm
X1: ASE-8.000MHz; Oscillator_SMD_Abracon_ASE-4Pin_3.2x2.5mm
X2: ECS-327-32.768kHz; Oscillator_SMD_Abracon_ASE-4Pin_3.2x2.5mm

Connections:
+3V3: C1.1, C5.1, C6.1, C7.1, C8.1, C9.1, C10.1, C11.1, C12.1, C13.1, C14.1, C15.1, C16.1, C17.1, C18.1, C19.1, C20.1, FB1.1, J7.3, J8.1, SW1.1, U1.6 (VBAT), U1.17 (VDD), U1.30 (VDD), U1.39 (VDD), U1.52 (VDD), U1.62 (VDD), U1.72 (VDD), U1.84 (VDD), U1.95 (VDD), U1.108 (VDD), U1.121 (VDD), U1.131 (VDD), U1.143 (PDR_ON), U1.144 (VDD), X1.1 (EN), X1.4 (Vdd), X2.1 (EN), X2.4 (Vdd); also elsewhere on the board
/1ST_MCU: U1.65 (PE12); also elsewhere on the board
/2ND_MCU: U1.64 (PE11); also elsewhere on the board
/3RD_MCU: U1.63 (PE10); also elsewhere on the board
/4TH_MCU: U1.60 (PE9); also elsewhere on the board
/5TH_MCU: U1.59 (PE8); also elsewhere on the board
/6TH_MCU: U1.58 (PE7); also elsewhere on the board
/12V_ADC: U1.47 (PB1); also elsewhere on the board
/BRAKE_LIGHT_EN: U1.18 (PF6); also elsewhere on the board
/BRAKE_LIGHT_I_SEN: U1.35 (PA1); also elsewhere on the board
/CAN1_RX: U1.103 (PA11); also elsewhere on the board
/CAN1_TX: U1.104 (PA12); also elsewhere on the board
/CAN2_RX: U1.73 (PB12); also elsewhere on the board
/CAN2_TX: U1.74 (PB13); also elsewhere on the board
/ENG_12V_ADC: U1.37 (PA3); also elsewhere on the board
/ENG_ON_EN: U1.14 (PF4); also elsewhere on the board
/ENG_ON_RLY_I_SEN: U1.26 (PC0); also elsewhere on the board
/ENG_START_EN: U1.15 (PF5); also elsewhere on the board
/ENG_START_RLY_I_SEN: U1.36 (PA2); also elsewhere on the board
/ENG_TEMP_ADC: U1.42 (PA6); also elsewhere on the board
/EXTRA_ADC: U1.46 (PB0); also elsewhere on the board
/FAULT_IND_MCU: U1.45 (PC5); also elsewhere on the board
/FUEL_LOW_ADC: U1.41 (PA5); also elsewhere on the board
/FUEL_LVL_ADC: U1.40 (PA4); also elsewhere on the board
/HIGHBEAM_EN: U1.19 (PF7); also elsewhere on the board
/HIGHBEAM_I_SEN: U1.34 (PA0); also elsewhere on the board
/HIGHBEAM_MCU: U1.55 (PF15); also elsewhere on the board
/HL_RLY_EN: U1.66 (PE13); also elsewhere on the board
/HORN_EN: U1.22 (PF10); also elsewhere on the board
/HORN_I_SEN: U1.27 (PC1); also elsewhere on the board
/I2C_SCL: U1.136 (PB6); also elsewhere on the board
/I2C_SDA: U1.137 (PB7); also elsewhere on the board
/KLINE_EN: U1.12 (PF2); also elsewhere on the board
/KLINE_RX: U1.102 (PA10); also elsewhere on the board
/KLINE_TX: U1.101 (PA9); also elsewhere on the board
/LAP_RLY_EN: U1.67 (PE14); also elsewhere on the board
/LED1: U1.139 (PB8); also elsewhere on the board
/LED2_B: U1.140 (PB9); also elsewhere on the board
/LED2_G: U1.82 (PD13); also elsewhere on the board
/LED2_R: U1.81 (PD12); also elsewhere on the board
/LOWBEAM_MCU: U1.54 (PF14); also elsewhere on the board
/L_TURN_SIG_EN: U1.20 (PF8); also elsewhere on the board
/L_TURN_SIG_I_SEN: U1.29 (PC3); also elsewhere on the board
/MAIN_RLY_EN: U1.13 (PF3); also elsewhere on the board
/NEUTRAL_MCU: U1.53 (PF13); also elsewhere on the board
/OIL_P_LOW_MCU: U1.49 (PF11); also elsewhere on the board
/PB2/BOOT1: U1.48 (PB2); also elsewhere on the board
/RS485_DIR: U1.118 (PD4); also elsewhere on the board
/RS485_RX: U1.122 (PD6); also elsewhere on the board
/RS485_TX: U1.119 (PD5); also elsewhere on the board
/R_TURN_SIG_EN: U1.21 (PF9); also elsewhere on the board
/R_TURN_SIG_I_SEN: U1.28 (PC2); also elsewhere on the board
/SERVO_12V_ADC: U1.43 (PA7); also elsewhere on the board
/SPI2_MISO: U1.75 (PB14); also elsewhere on the board
/SPI2_MOSI: U1.76 (PB15); also elsewhere on the board
/SPI2_SCK: U1.117 (PD3); also elsewhere on the board
/STM32F429/GND-detect: J7.11, R10.2
/STM32F429/JRST: JP1.3 (B), U1.134 (PB4)
/STM32F429/JTDI: J7.10, U1.110 (PA15)
/STM32F429/JTDO-SWO: J7.8, J8.6, U1.133 (PB3)
/STM32F429/JTICK-SWCLK: J7.6, J8.2, U1.109 (PA14)
/STM32F429/JTMS-SWDIO: J7.4, J8.4, U1.105 (PA13)
/STM32F429/NRST: C2.2, JP1.1 (A), SW2.2, U1.25 (NRST)
/STM32F429/OSC32_IN: R12.2, U1.8 (PC14)
/STM32F429/OSC32_OUT: U1.9 (PC15)
/STM32F429/OSC_IN: R11.2, U1.23 (PH0)
/STM32F429/OSC_OUT: U1.24 (PH1)
/STM32F429/RESET: J7.12, J8.5, JP1.2 (C)
/STM32F429/USART3_RX: J7.13, U1.70 (PB11)
/STM32F429/USART3_TX: J7.14, U1.69 (PB10)
/TACH_MCU: U1.50 (PF12); also elsewhere on the board
/TURN_L_MCU: U1.56 (PG0); also elsewhere on the board
/TURN_R_MCU: U1.57 (PG1); also elsewhere on the board
/UART4_RX: U1.112 (PC11); also elsewhere on the board
/UART4_TX: U1.111 (PC10); also elsewhere on the board
/VSS_MCU: U1.44 (PC4); also elsewhere on the board
GND: C2.1, C3.1, C4.1, C5.2, C6.2, C7.2, C8.2, C9.2, C10.2, C11.2, C12.2, C13.2, C14.2, C15.2, C16.2, C17.2, C18.2, C19.2, C20.2, C21.2, C22.2, J7.5, J7.7, J8.3, R8.1, R10.1, SW2.1, U1.16 (VSS), U1.31 (VSSA), U1.38 (VSS), U1.51 (VSS), U1.61 (VSS), U1.83 (VSS), U1.94 (VSS), U1.107 (VSS), U1.120 (VSS), U1.130 (VSS), X1.2 (GND), X2.2 (GND); also elsewhere on the board
unnamed: C1.2, R8.2, SW1.2, U1.138 (BOOT0)
unnamed: C3.2, U1.71 (VCAP_1)
unnamed: C4.2, U1.106 (VCAP_2)
unnamed: R9.2, U1.32 (VREF+)
unnamed: R11.1, X1.3 (OUT)
unnamed: R12.1, X2.3 (OUT)
VDDA: C21.1, C22.1, FB1.2, R9.1, U1.33 (VDDA)

Notes on the sheet:
Bypass caps for pins 17, 30, 39, 52, 62, 72, 84, 95, 108, 121, 131, 144
Bypass cap for VBAT
Matches STLINK V2
STDC14 JTAG/SWD
Pins 13 & 14 to STLINK virtual comm port (VCP)

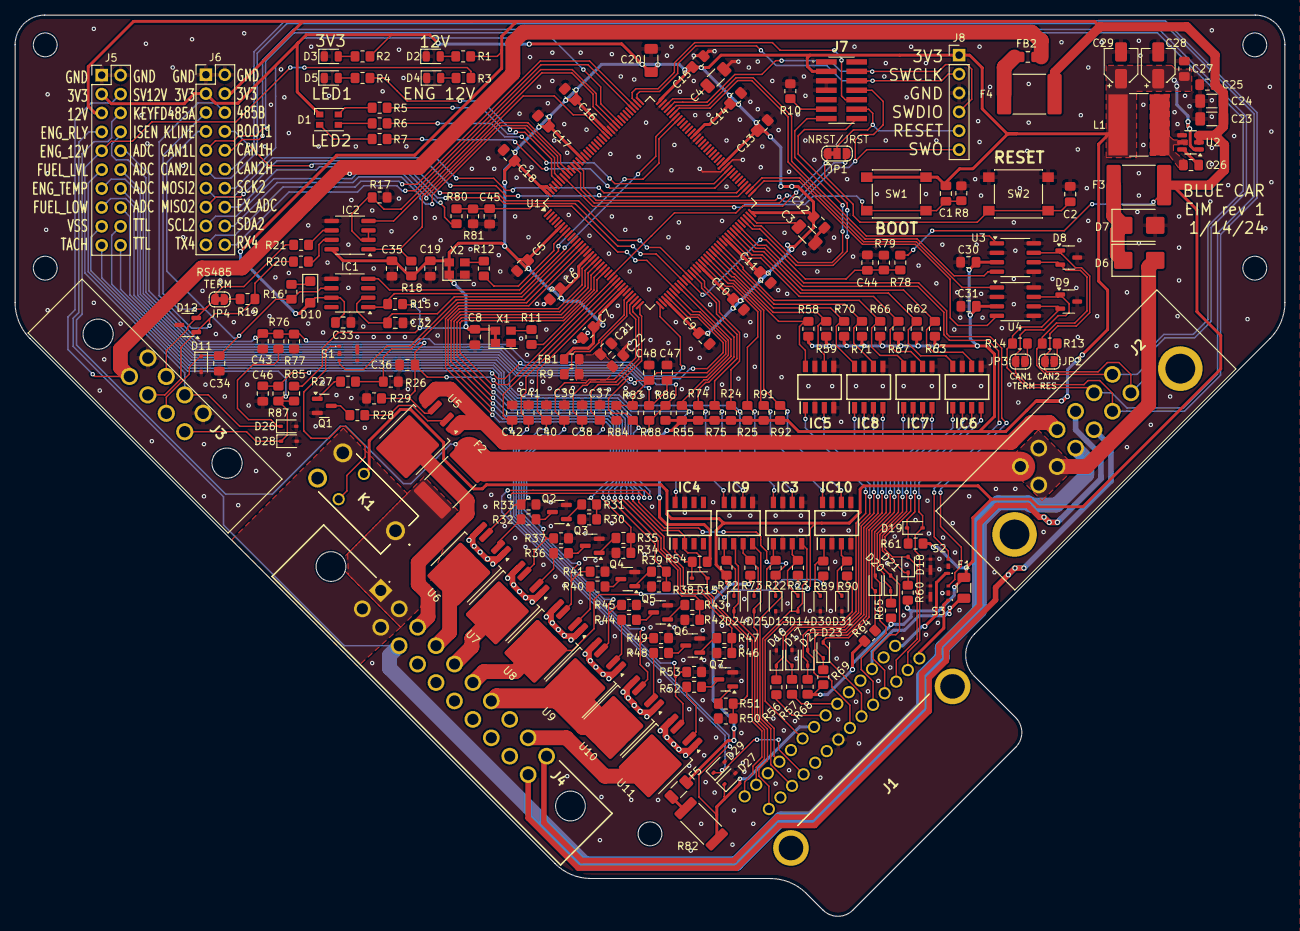
[picture p43: board EIM.kicad_pcb from above]

Board: 2 copper layers, 170.6 x 121.1 mm, 227 parts (0 on the bottom side), 187 nets.
