bhorst519/bluecar/VCU/firmware/Core/Src/main.c

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
/* Includes ------------------------------------------------------------------*/
#include "main.h"
#include "string.h"
#include "cmsis_os.h"

/* USER CODE BEGIN Includes */
#include "halWrappersConfig.h"
#include "profiler.h"
#include "rtos.h"

/* USER CODE END Includes */


ETH_TxPacketConfig TxConfig;
ETH_DMADescTypeDef  DMARxDscrTab[ETH_RX_DESC_CNT]; /* Ethernet Rx DMA Descriptors */
ETH_DMADescTypeDef  DMATxDscrTab[ETH_TX_DESC_CNT]; /* Ethernet Tx DMA Descriptors */

ADC_HandleTypeDef hadc1;

CAN_HandleTypeDef hcan1;

ETH_HandleTypeDef heth;

TIM_HandleTypeDef htim5;

UART_HandleTypeDef huart3;

PCD_HandleTypeDef hpcd_USB_OTG_FS;

osThreadId defaultTaskHandle;
uint32_t defaultTaskBuffer[ 256 ];
osStaticThreadDef_t defaultTaskControlBlock;
osThreadId Task1kHzHandle;
uint32_t Task1kHzBuffer[ 256 ];
osStaticThreadDef_t Task1kHzControlBlock;
osThreadId Task100HzHandle;
uint32_t Task100HzBuffer[ 256 ];
osStaticThreadDef_t Task100HzControlBlock;
osThreadId Task10HzHandle;
uint32_t Task10HzBuffer[ 256 ];
osStaticThreadDef_t Task10HzControlBlock;
osThreadId Task1HzHandle;
uint32_t Task1HzBuffer[ 256 ];
osStaticThreadDef_t Task1HzControlBlock;
/* USER CODE BEGIN PV */

HalWrappers_Config_S gHalWrappersConfig =
{
  .pAdc = &hadc1,
  .pUsTim = &htim5,
  .pCan = {&hcan1},
};

static Profiler_Data_S g1kHzProfilerData;
static Profiler_Data_S g100HzProfilerData;
static Profiler_Data_S g10HzProfilerData;
static Profiler_Data_S g1HzProfilerData;

/* USER CODE END PV */

void SystemClock_Config(void);
static void MX_GPIO_Init(void);
static void MX_CAN1_Init(void);
static void MX_ETH_Init(void);
static void MX_USART3_UART_Init(void);
static void MX_USB_OTG_FS_PCD_Init(void);
static void MX_ADC1_Init(void);
static void MX_TIM5_Init(void);
void StartDefaultTask(void const * argument);
void StartTask1kHz(void const * argument);
void StartTask100Hz(void const * argument);
void StartTask10Hz(void const * argument);
void StartTask1Hz(void const * argument);

/**
  * @brief  The application entry point.
  * @retval int
  */
int main(void)
{

  /* MCU Configuration--------------------------------------------------------*/

  /* Reset of all peripherals, Initializes the Flash interface and the Systick. */
  HAL_Init();

  /* Configure the system clock */
  SystemClock_Config();

  /* Initialize all configured peripherals */
  MX_GPIO_Init();
  MX_CAN1_Init();
  MX_ETH_Init();
  MX_USART3_UART_Init();
  MX_USB_OTG_FS_PCD_Init();
  MX_ADC1_Init();
  MX_TIM5_Init();
  /* USER CODE BEGIN 2 */
  RtosInit();
  /* USER CODE END 2 */

  /* USER CODE BEGIN RTOS_MUTEX */
  /* add mutexes, ... */
  /* USER CODE END RTOS_MUTEX */

  /* USER CODE BEGIN RTOS_SEMAPHORES */
  /* add semaphores, ... */
  /* USER CODE END RTOS_SEMAPHORES */

  /* USER CODE BEGIN RTOS_TIMERS */
  /* start timers, add new ones, ... */
  /* USER CODE END RTOS_TIMERS */

  /* USER CODE BEGIN RTOS_QUEUES */
  /* add queues, ... */
  /* USER CODE END RTOS_QUEUES */

  /* Create the thread(s) */
  /* definition and creation of defaultTask */
  osThreadStaticDef(defaultTask, StartDefaultTask, osPriorityIdle, 0, 256, defaultTaskBuffer, &defaultTaskControlBlock);
  defaultTaskHandle = osThreadCreate(osThread(defaultTask), NULL);

  /* definition and creation of Task1kHz */
  osThreadStaticDef(Task1kHz, StartTask1kHz, osPriorityRealtime, 0, 256, Task1kHzBuffer, &Task1kHzControlBlock);
  Task1kHzHandle = osThreadCreate(osThread(Task1kHz), NULL);

  /* definition and creation of Task100Hz */
  osThreadStaticDef(Task100Hz, StartTask100Hz, osPriorityHigh, 0, 256, Task100HzBuffer, &Task100HzControlBlock);
  Task100HzHandle = osThreadCreate(osThread(Task100Hz), NULL);

  /* definition and creation of Task10Hz */
  osThreadStaticDef(Task10Hz, StartTask10Hz, osPriorityAboveNormal, 0, 256, Task10HzBuffer, &Task10HzControlBlock);
  Task10HzHandle = osThreadCreate(osThread(Task10Hz), NULL);

  /* definition and creation of Task1Hz */
  osThreadStaticDef(Task1Hz, StartTask1Hz, osPriorityNormal, 0, 256, Task1HzBuffer, &Task1HzControlBlock);
  Task1HzHandle = osThreadCreate(osThread(Task1Hz), NULL);

  /* USER CODE BEGIN RTOS_THREADS */
  /* add threads, ... */
  g1kHzProfilerData.configWindowNumPeriods = 1000U; // 1kHz
  vTaskSetThreadLocalStoragePointer(Task1kHzHandle, THREAD_LOCAL_STORAGE_PROFILER_IDX, (void *)&g1kHzProfilerData);
  ProfilerScheduledTaskRegister(PROFILER_TASK_1KHZ, (void *)Task1kHzHandle);

  g100HzProfilerData.configWindowNumPeriods = 100U; // 100Hz
  vTaskSetThreadLocalStoragePointer(Task100HzHandle, THREAD_LOCAL_STORAGE_PROFILER_IDX, (void *)&g100HzProfilerData);
  ProfilerScheduledTaskRegister(PROFILER_TASK_100HZ, (void *)Task100HzHandle);

  g10HzProfilerData.configWindowNumPeriods = 10U; // 10Hz
  vTaskSetThreadLocalStoragePointer(Task10HzHandle, THREAD_LOCAL_STORAGE_PROFILER_IDX, (void *)&g10HzProfilerData);
  ProfilerScheduledTaskRegister(PROFILER_TASK_10HZ, (void *)Task10HzHandle);

  g1HzProfilerData.configWindowNumPeriods = 2U; // 1Hz * 2
  vTaskSetThreadLocalStoragePointer(Task1HzHandle, THREAD_LOCAL_STORAGE_PROFILER_IDX, (void *)&g1HzProfilerData);
  ProfilerScheduledTaskRegister(PROFILER_TASK_1HZ, (void *)Task1HzHandle);
  /* USER CODE END RTOS_THREADS */

  /* Start scheduler */
  osKernelStart();

  /* We should never get here as control is now taken by the scheduler */

  /* Infinite loop */
  /* USER CODE BEGIN WHILE */
  while (1)
  {
    /* USER CODE END WHILE */

    /* USER CODE BEGIN 3 */
  }
  /* USER CODE END 3 */
}

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
/* USER CODE BEGIN Header_StartDefaultTask */
/**
  * @brief  Function implementing the defaultTask thread.
  * @param  argument: Not used
  * @retval None
  */
/* USER CODE END Header_StartDefaultTask */
void StartDefaultTask(void const * argument)
{
  /* USER CODE BEGIN 5 */
  /* Infinite loop */
  for(;;)
  {
    osDelay(1);
  }
  /* USER CODE END 5 */
}

/* USER CODE BEGIN Header_StartTask1kHz */
/**
* @brief Function implementing the Task1kHz thread.
* @param argument: Not used
* @retval None
*/
/* USER CODE END Header_StartTask1kHz */
void StartTask1kHz(void const * argument)
{
  /* USER CODE BEGIN StartTask1kHz */
  (void)argument;
  RtosRunTask1kHz();
  /* USER CODE END StartTask1kHz */
}

/* USER CODE BEGIN Header_StartTask100Hz */
/**
* @brief Function implementing the Task100Hz thread.
* @param argument: Not used
* @retval None
*/
/* USER CODE END Header_StartTask100Hz */
void StartTask100Hz(void const * argument)
{
  /* USER CODE BEGIN StartTask100Hz */
  (void)argument;
  RtosRunTask100Hz();
  /* USER CODE END StartTask100Hz */
}

/* USER CODE BEGIN Header_StartTask10Hz */
/**
* @brief Function implementing the Task10Hz thread.
* @param argument: Not used
* @retval None
*/
/* USER CODE END Header_StartTask10Hz */
void StartTask10Hz(void const * argument)
{
  /* USER CODE BEGIN StartTask10Hz */
  (void)argument;
  RtosRunTask10Hz();
  /* USER CODE END StartTask10Hz */
}

/* USER CODE BEGIN Header_StartTask1Hz */
/**
* @brief Function implementing the Task1Hz thread.
* @param argument: Not used
* @retval None
*/
/* USER CODE END Header_StartTask1Hz */
void StartTask1Hz(void const * argument)
{
  /* USER CODE BEGIN StartTask1Hz */
  (void)argument;
  RtosRunTask1Hz();
  /* USER CODE END StartTask1Hz */
}

/**
  * @brief  Period elapsed callback in non blocking mode
  * @note   This function is called  when TIM2 interrupt took place, inside
  * HAL_TIM_IRQHandler(). It makes a direct call to HAL_IncTick() to increment
  * a global variable "uwTick" used as application time base.
  * @param  htim : TIM handle
  * @retval None
  */
void HAL_TIM_PeriodElapsedCallback(TIM_HandleTypeDef *htim)
{
  if (htim->Instance == TIM2) {
    HAL_IncTick();
  }
}

/**
  * @brief  This function is executed in case of error occurrence.
  * @retval None
  */
void Error_Handler(void)
{
  /* USER CODE BEGIN Error_Handler_Debug */
  /* User can add his own implementation to report the HAL error return state */
  __disable_irq();
  while (1)
  {
  }
  /* USER CODE END Error_Handler_Debug */
}

#ifdef  USE_FULL_ASSERT
/**
  * @brief  Reports the name of the source file and the source line number
  *         where the assert_param error has occurred.
  * @param  file: pointer to the source file name
  * @param  line: assert_param error line source number
  * @retval None
  */
void assert_failed(uint8_t *file, uint32_t line)
{
  /* USER CODE BEGIN 6 */
  /* User can add his own implementation to report the file name and line number,
     ex: printf("Wrong parameters value: file %s on line %d\r\n", file, line) */
  /* USER CODE END 6 */
}
#endif /* USE_FULL_ASSERT */
