bhorst519/bluecar/shared/servo/servoData.hpp

#ifndef SERVO_DATA_HPP
#define SERVO_DATA_HPP

/***************************************************************************************************
*                                         I N C L U D E S                                          *
***************************************************************************************************/
#include "qualifiedVal.hpp"
#include "util.h"

using namespace ::QualifiedVal;

/***************************************************************************************************
*                                         T Y P E D E F S                                          *
***************************************************************************************************/
namespace Shared
{

struct ServoData_S
{
    uint8_t id;
    float_q positionDegrees;
    float_q lossOfCommPositionDegrees;
    float_q lossOfCommTimeout;
    float_q current;
    float_q temperature;
    float_q voltage;
};

} // namespace Shared

#endif // SERVO_DATA_HPP
