bhorst519/bluecar/EIM/firmware/app/tx/txModule.cpp

/***************************************************************************************************
*                                         I N C L U D E S                                          *
***************************************************************************************************/
#include "cmsis_os.h"
#include "PT_canTransmitter.hpp"
#include "profiler.h"
#include "txModule.hpp"

/***************************************************************************************************
*                                P R I V A T E   F U N C T I O N S                                 *
***************************************************************************************************/
namespace
{

inline float ProfilerGetAvgPeriodMs(const Profiler_E profiler)
{
    return static_cast<float>(ProfilerGetAvgPeriodUs(profiler)) * 0.001F;
}

inline float ProfilerGetMinPeriodMs(const Profiler_E profiler)
{
    return static_cast<float>(ProfilerGetMinPeriodUs(profiler)) * 0.001F;
}

inline float ProfilerGetMaxPeriodMs(const Profiler_E profiler)
{
    return static_cast<float>(ProfilerGetMaxPeriodUs(profiler)) * 0.001F;
}

} // namespace (anonymous)

/***************************************************************************************************
*                                 M E T H O D  D E F I N I T I O N S                               *
***************************************************************************************************/
namespace Eim
{

using namespace CanGen;

void TxNoneModule::Transmit(void)
{
    // Nothing to do
}

void Tx1kHzModule::Transmit(void)
{
    taskENTER_CRITICAL();
    CANTX_PT_SetS_EIM_PCBA_TachFreq(m_tachRef.GetFreq().Convert(uint32_t()));
    CANTX_PT_SetS_EIM_PCBA_TachRpm(m_tachRef.GetRpm().Convert(uint32_t()));
    taskEXIT_CRITICAL();
}

void Tx100HzModule::Transmit(void)
{
    taskENTER_CRITICAL();
    CANTX_PT_SetS_EIM_PCBA_DieTemp(m_adcRef.GetAdcFilt10Hz(ANALOG_DIE_TEMP).Convert(int32_t()));
    CANTX_PT_SetS_EIM_PCBA_12V(m_adcRef.GetAdcFilt10Hz(ANALOG_12V));
    CANTX_PT_SetS_EIM_PCBA_Servo12V(m_adcRef.GetAdcFilt10Hz(ANALOG_SERVO_12V));
    CANTX_PT_SetS_EIM_PCBA_Eng12V(m_adcRef.GetAdcFilt10Hz(ANALOG_ENG_12V));
    CANTX_PT_SetS_EIM_PCBA_EngOnCurrent(m_adcRef.GetAdcFilt10Hz(ANALOG_ENG_ON_ISENSE));
    CANTX_PT_SetS_EIM_PCBA_EngStartCurrent(m_adcRef.GetAdcFilt10Hz(ANALOG_ENG_START_ISENSE));
    CANTX_PT_SetS_EIM_PCBA_BrakeLightCurrent(m_adcRef.GetAdcFilt10Hz(ANALOG_BRAKE_LIGHT_ISENSE));
    CANTX_PT_SetS_EIM_PCBA_TurnRCurrent(m_adcRef.GetAdcFilt10Hz(ANALOG_TURN_R_ISENSE));
    CANTX_PT_SetS_EIM_PCBA_TurnLCurrent(m_adcRef.GetAdcFilt10Hz(ANALOG_TURN_L_ISENSE));
    CANTX_PT_SetS_EIM_PCBA_HighBeamCurrent(m_adcRef.GetAdcFilt10Hz(ANALOG_HIGH_BEAM_ISENSE));
    CANTX_PT_SetS_EIM_PCBA_HornCurrent(m_adcRef.GetAdcFilt10Hz(ANALOG_HORN_ISENSE));
    taskEXIT_CRITICAL();

    taskENTER_CRITICAL();
    CANTX_PT_SetS_EIM_PCBA_EngTempV(m_adcRef.GetAdcFilt10Hz(ANALOG_ENG_TEMP));
    CANTX_PT_SetS_EIM_PCBA_FuelLevelV(m_adcRef.GetAdcFilt10Hz(ANALOG_FUEL_LEVEL));
    CANTX_PT_SetS_EIM_PCBA_FuelLowV(m_adcRef.GetAdcFilt10Hz(ANALOG_FUEL_LOW));
    taskEXIT_CRITICAL();

    taskENTER_CRITICAL();
    CANTX_PT_SetS_EIM_PCBA_GearN(static_cast<uint32_t>(m_ioIntRef.GetGearN()));
    CANTX_PT_SetS_EIM_PCBA_Gear1(static_cast<uint32_t>(m_ioIntRef.GetGear1()));
    CANTX_PT_SetS_EIM_PCBA_Gear2(static_cast<uint32_t>(m_ioIntRef.GetGear2()));
    CANTX_PT_SetS_EIM_PCBA_Gear3(static_cast<uint32_t>(m_ioIntRef.GetGear3()));
    CANTX_PT_SetS_EIM_PCBA_Gear4(static_cast<uint32_t>(m_ioIntRef.GetGear4()));
    CANTX_PT_SetS_EIM_PCBA_Gear5(static_cast<uint32_t>(m_ioIntRef.GetGear5()));
    CANTX_PT_SetS_EIM_PCBA_Gear6(static_cast<uint32_t>(m_ioIntRef.GetGear6()));
    CANTX_PT_SetS_EIM_PCBA_GearSelect(static_cast<uint32_t>(m_ioIntRef.GetGearSelect()));
    taskEXIT_CRITICAL();

    taskENTER_CRITICAL();
    CANTX_PT_SetS_EIM_PCBA_TurnRight(static_cast<uint32_t>(m_ioIntRef.GetTurnRight()));
    CANTX_PT_SetS_EIM_PCBA_TurnLeft(static_cast<uint32_t>(m_ioIntRef.GetTurnLeft()));
    CANTX_PT_SetS_EIM_PCBA_LowBeam(static_cast<uint32_t>(m_ioIntRef.GetLowBeam()));
    CANTX_PT_SetS_EIM_PCBA_HighBeam(static_cast<uint32_t>(m_ioIntRef.GetHighBeam()));
    CANTX_PT_SetS_EIM_PCBA_FaultIndicator(static_cast<uint32_t>(m_ioIntRef.GetFaultIndicator()));
    CANTX_PT_SetS_EIM_PCBA_OilPressureLow(static_cast<uint32_t>(m_ioIntRef.GetOilPressureLow()));
    taskEXIT_CRITICAL();
}

void Tx10HzModule::Transmit(void)
{
    taskENTER_CRITICAL();
    CANTX_PT_SetS_EIM_Servo_Current(m_servoRef.GetCurrent());
    CANTX_PT_SetS_EIM_Servo_Id(m_servoRef.GetId());
    CANTX_PT_SetS_EIM_Servo_LossOfCommPosition(m_servoRef.GetLossOfCommPositionDegrees());
    CANTX_PT_SetS_EIM_Servo_LossOfCommTimeout(m_servoRef.GetLossOfCommTimeout().Convert(uint32_t()));
    CANTX_PT_SetS_EIM_Servo_Position(m_servoRef.GetPositionDegrees());
    CANTX_PT_SetS_EIM_Servo_Temp(m_servoRef.GetTemperature().Convert(int32_t()));
    CANTX_PT_SetS_EIM_Servo_Voltage(m_servoRef.GetVoltage());
    taskEXIT_CRITICAL();
}

void Tx1HzModule::Transmit(void)
{
    // CPU load
    taskENTER_CRITICAL();
    CANTX_PT_SetS_EIM_CPU_Load(ProfilerGetTotalLoad() * 100.0F);
    CANTX_PT_SetS_EIM_1kHz_Load(ProfilerGetLoad(PROFILER_TASK_1KHZ) * 100.0F);
    CANTX_PT_SetS_EIM_100Hz_Load(ProfilerGetLoad(PROFILER_TASK_100HZ) * 100.0F);
    CANTX_PT_SetS_EIM_10Hz_Load(ProfilerGetLoad(PROFILER_TASK_10HZ) * 100.0F);
    CANTX_PT_SetS_EIM_1Hz_Load(ProfilerGetLoad(PROFILER_TASK_1HZ) * 100.0F);
    taskEXIT_CRITICAL();

    // 1kHz task data
    taskENTER_CRITICAL();
    CANTX_PT_SetS_EIM_1kHz_AvgPeriod(ProfilerGetAvgPeriodMs(PROFILER_TASK_1KHZ));
    CANTX_PT_SetS_EIM_1kHz_MinPeriod(ProfilerGetMinPeriodMs(PROFILER_TASK_1KHZ));
    CANTX_PT_SetS_EIM_1kHz_MaxPeriod(ProfilerGetMaxPeriodMs(PROFILER_TASK_1KHZ));
    taskEXIT_CRITICAL();

    // 100Hz task data
    taskENTER_CRITICAL();
    CANTX_PT_SetS_EIM_100Hz_AvgPeriod(ProfilerGetAvgPeriodMs(PROFILER_TASK_100HZ));
    CANTX_PT_SetS_EIM_100Hz_MinPeriod(ProfilerGetMinPeriodMs(PROFILER_TASK_100HZ));
    CANTX_PT_SetS_EIM_100Hz_MaxPeriod(ProfilerGetMaxPeriodMs(PROFILER_TASK_100HZ));
    taskEXIT_CRITICAL();

    // 10Hz task data
    taskENTER_CRITICAL();
    CANTX_PT_SetS_EIM_10Hz_AvgPeriod(ProfilerGetAvgPeriodMs(PROFILER_TASK_10HZ));
    CANTX_PT_SetS_EIM_10Hz_MinPeriod(ProfilerGetMinPeriodMs(PROFILER_TASK_10HZ));
    CANTX_PT_SetS_EIM_10Hz_MaxPeriod(ProfilerGetMaxPeriodMs(PROFILER_TASK_10HZ));
    taskEXIT_CRITICAL();

    // 1Hz task data
    taskENTER_CRITICAL();
    CANTX_PT_SetS_EIM_1Hz_AvgPeriod(ProfilerGetAvgPeriodMs(PROFILER_TASK_1HZ));
    CANTX_PT_SetS_EIM_1Hz_MinPeriod(ProfilerGetMinPeriodMs(PROFILER_TASK_1HZ));
    CANTX_PT_SetS_EIM_1Hz_MaxPeriod(ProfilerGetMaxPeriodMs(PROFILER_TASK_1HZ));
    taskEXIT_CRITICAL();

    // ADC conversion data
    taskENTER_CRITICAL();
    CANTX_PT_SetS_EIM_ADC_AvgPeriod(ProfilerGetAvgPeriodMs(PROFILER_ADC_CONV));
    CANTX_PT_SetS_EIM_ADC_MinPeriod(ProfilerGetMinPeriodMs(PROFILER_ADC_CONV));
    CANTX_PT_SetS_EIM_ADC_MaxPeriod(ProfilerGetMaxPeriodMs(PROFILER_ADC_CONV));
    taskEXIT_CRITICAL();

    // K-line data
    taskENTER_CRITICAL();
    CANTX_PT_SetS_EIM_ECM_BatteryVoltage(m_klineRef.GetBatteryVoltage());
    CANTX_PT_SetS_EIM_ECM_EctTemp(m_klineRef.GetEctTemp().Convert(int32_t()));
    CANTX_PT_SetS_EIM_ECM_EctVoltage(m_klineRef.GetEctVoltage());
    CANTX_PT_SetS_EIM_ECM_IatTemp(m_klineRef.GetIatTemp().Convert(int32_t()));
    CANTX_PT_SetS_EIM_ECM_IatVoltage(m_klineRef.GetIatVoltage());
    CANTX_PT_SetS_EIM_ECM_MapPressure(m_klineRef.GetMapPressure().Convert(uint32_t()));
    CANTX_PT_SetS_EIM_ECM_MapVoltage(m_klineRef.GetMapVoltage());
    CANTX_PT_SetS_EIM_ECM_Rpm(m_klineRef.GetRpm().Convert(uint32_t()));
    CANTX_PT_SetS_EIM_ECM_TpsAngle(m_klineRef.GetTpsAngle());
    CANTX_PT_SetS_EIM_ECM_TpsVoltage(m_klineRef.GetTpsVoltage());
    CANTX_PT_SetS_EIM_ECM_VehicleSpeed(m_klineRef.GetVehicleSpeed().Convert(uint32_t()));
    taskEXIT_CRITICAL();
}

} // namespace Eim
