bhorst519/bluecar/VCU/firmware/app/adc/adcData.hpp

#ifndef ADC_DATA_HPP
#define ADC_DATA_HPP

/***************************************************************************************************
*                                         I N C L U D E S                                          *
***************************************************************************************************/
#include "halWrappersConfig.h"
#include "qualifiedValTypes.hpp"
#include "util.h"

/***************************************************************************************************
*                                          D E F I N E S                                           *
***************************************************************************************************/
namespace Vcu
{

static constexpr size_t NUM_ADC {static_cast<size_t>(MAX_NUM_ANALOG)};

/***************************************************************************************************
*                                         T Y P E D E F S                                          *
***************************************************************************************************/
struct AdcData_S
{
    float_q adcFilt10Hz[NUM_ADC];
};

} // namespace Vcu

#endif // ADC_DATA_HPP
