bhorst519/bluecar/(commit log)

2024-06-09 Board ready to order
    [EIM_devboard.kicad_pcb, EIM_devboard.sch]
2024-06-11 Ordered version of EIM dev board
    [EIM_devboard.csv, EIM_devboard.kicad_pcb, EIM_devboard.kicad_sch]
2024-07-14 Working CAN demo
    [EIM_devboard.kicad_pcb]
2024-07-15 Working gear check and CAN message
2024-07-30 Working printf to terminal and interrupt test
2024-11-25 HAL wrapper cleanup
    Kline interface module
    UART support
2024-12-09 EIM schematic nearly complete. Missing ADC inputs and MCU pin assignments.
    [CAN_transceiver.kicad_sch, EIM.kicad_pcb, EIM.kicad_sch, RS485.kicad_sch, STM32F429.kicad_sch, highside_driver_7A.kicad_sch, iso_12V_input.kicad_sch, iso_3V3_input.kicad_sch]
2024-12-20 added Arjun's comments, assigned some MCU pins
    [CAN_transceiver.kicad_sch, RS485.kicad_sch, STM32F429.kicad_sch, analog_inputs.kicad_sch, highside_driver_7A.kicad_sch, iso_12V_input.kicad_sch, iso_3V3_input.kicad_sch, kline.kicad_sch]
2025-01-06 Throttle servo module
2025-01-08 Layout 75% done, before 8V bus deletion
    [CAN_transceiver.kicad_sch, EIM.kicad_pcb, EIM.kicad_sch, RS485.kicad_sch, STM32F429.kicad_sch, analog_inputs.kicad_sch, highside_driver_7A.kicad_sch, iso_12V_input.kicad_sch]
2025-01-09 servo cleanup
2025-01-12 fixing mistakes I found
    [servoModule.cpp]
2025-01-12 All components placed and pins assigned.
    [CAN_transceiver.kicad_sch, EIM.kicad_pcb, EIM.kicad_sch, RS485.kicad_sch, STM32F429.kicad_sch, analog_inputs.kicad_sch, highside_driver_7A.kicad_sch, iso_12V_input.kicad_sch]
2025-01-13 EIM board complete - awaiting DR
    [EIM.kicad_pcb]
2025-01-14 update status qualifiers for servo data
2025-01-15 Updated small things to make DRC pass without errors or warnings
    [EIM.kicad_pcb, EIM_BOM.xlsx, EIM_bom.csv]
2025-01-15 Board data as ordered on 1-15-25
    [EIM-B_Cu.gbr, EIM-B_Mask.gbr, EIM-B_Paste.gbr, EIM-B_SilkS.gbr, EIM-Edge_Cuts.gbr, EIM-F_Cu.gbr, EIM-F_Mask.gbr, EIM-F_Paste.gbr]
2025-01-20 set servo position demo
2025-02-08 EIM/development_X delete
    [EIM_devboard.csv, EIM_devboard.kicad_pcb, EIM_devboard.kicad_sch, EIM_devboard.sch]
2025-02-12 Added pdf of ordered version
    [EIM.kicad_pcb, Quotation T-D127W49597A-3sets-EIM_BOM(2025-01-16)-BH-responses.xls]
2025-03-04 relay test
2025-03-16 ADC conversion bringup
2025-03-16 ADC profiler
    Transmit initial ADC info
2025-03-16 add 100Hz task and do ADC stuff there
2025-03-16 filter ADC values
2025-03-18 agree on 'uart' over 'serial'
2025-03-23 More ADC conversions
2025-03-23 fix brake en pin config
    [EIM.ioc, main.c]
2025-03-23 fix third pin config
    [EIM.ioc, main.c]
2025-04-13 configure tach interrupt
2025-04-20 Attempt EIM servo comms
    Time-based interrupts, using microsecond timer
2025-04-21 Completed schematic - ready for layout
    [CAN_transceiver.kicad_sch, temp_vcu.kicad_pcb, temp_vcu.kicad_sch]
2025-04-21 Shared kline and servo modules
2025-04-22 Ordered version of board
    [CAN_transceiver.kicad_sch, temp_vcu.kicad_pcb, temp_vcu.kicad_sch]
2025-04-26 better filtering for CAN RX signals
2025-04-27 configure tim5 as uSec timer
2025-04-27 configure can1 for 500k with RX interrupts
2025-04-27 configure ADC interrupts
2025-04-27 configure tim5 interrupts
2025-04-28 more ADC
2025-04-29 TX IO and ADC data
2025-04-29 prototype VCU <-> EIM comms
2025-05-01 EIM ThrottleModule for servo position
2025-05-17 limit throttle
2025-05-18 fixes from drive testing
    [klineCommTypes.hpp, klineModule.cpp]
